Tecnologic/hardware_4850/jacobi.kicad_pcb

## KiCad design jacobi.kicad_pcb (2026-11-06)

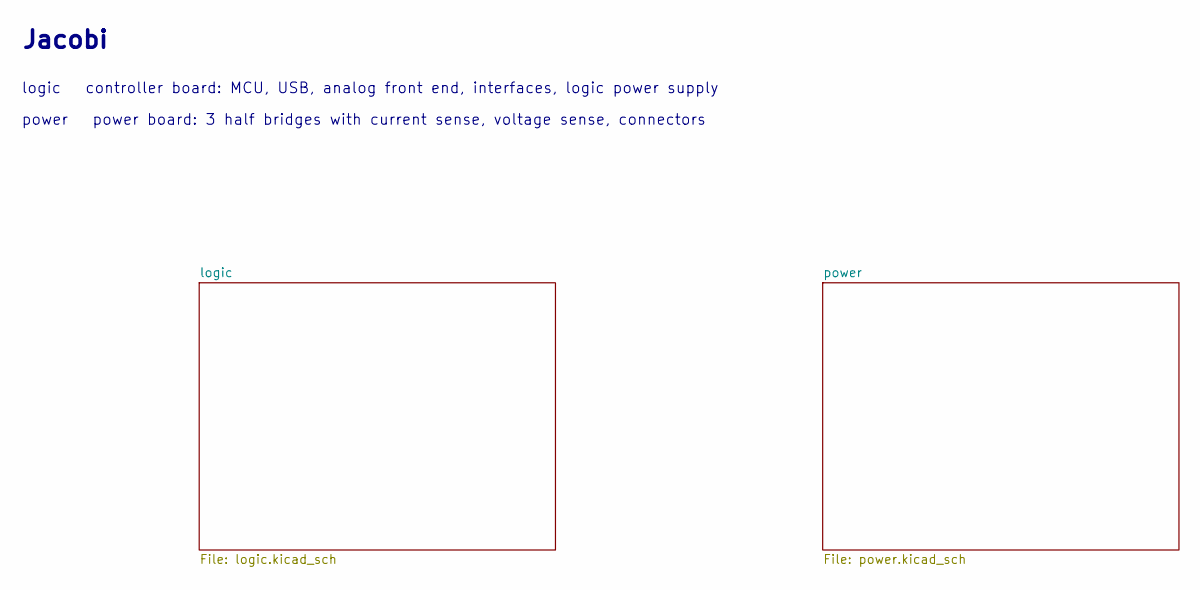
[picture p1: schematic jacobi.kicad_sch]

Notes on the sheet:
Jacobi
logic controller board: MCU, USB, analog front end, interfaces, logic power supply
power power board: 3 half bridges with current sense, voltage sense, connectors

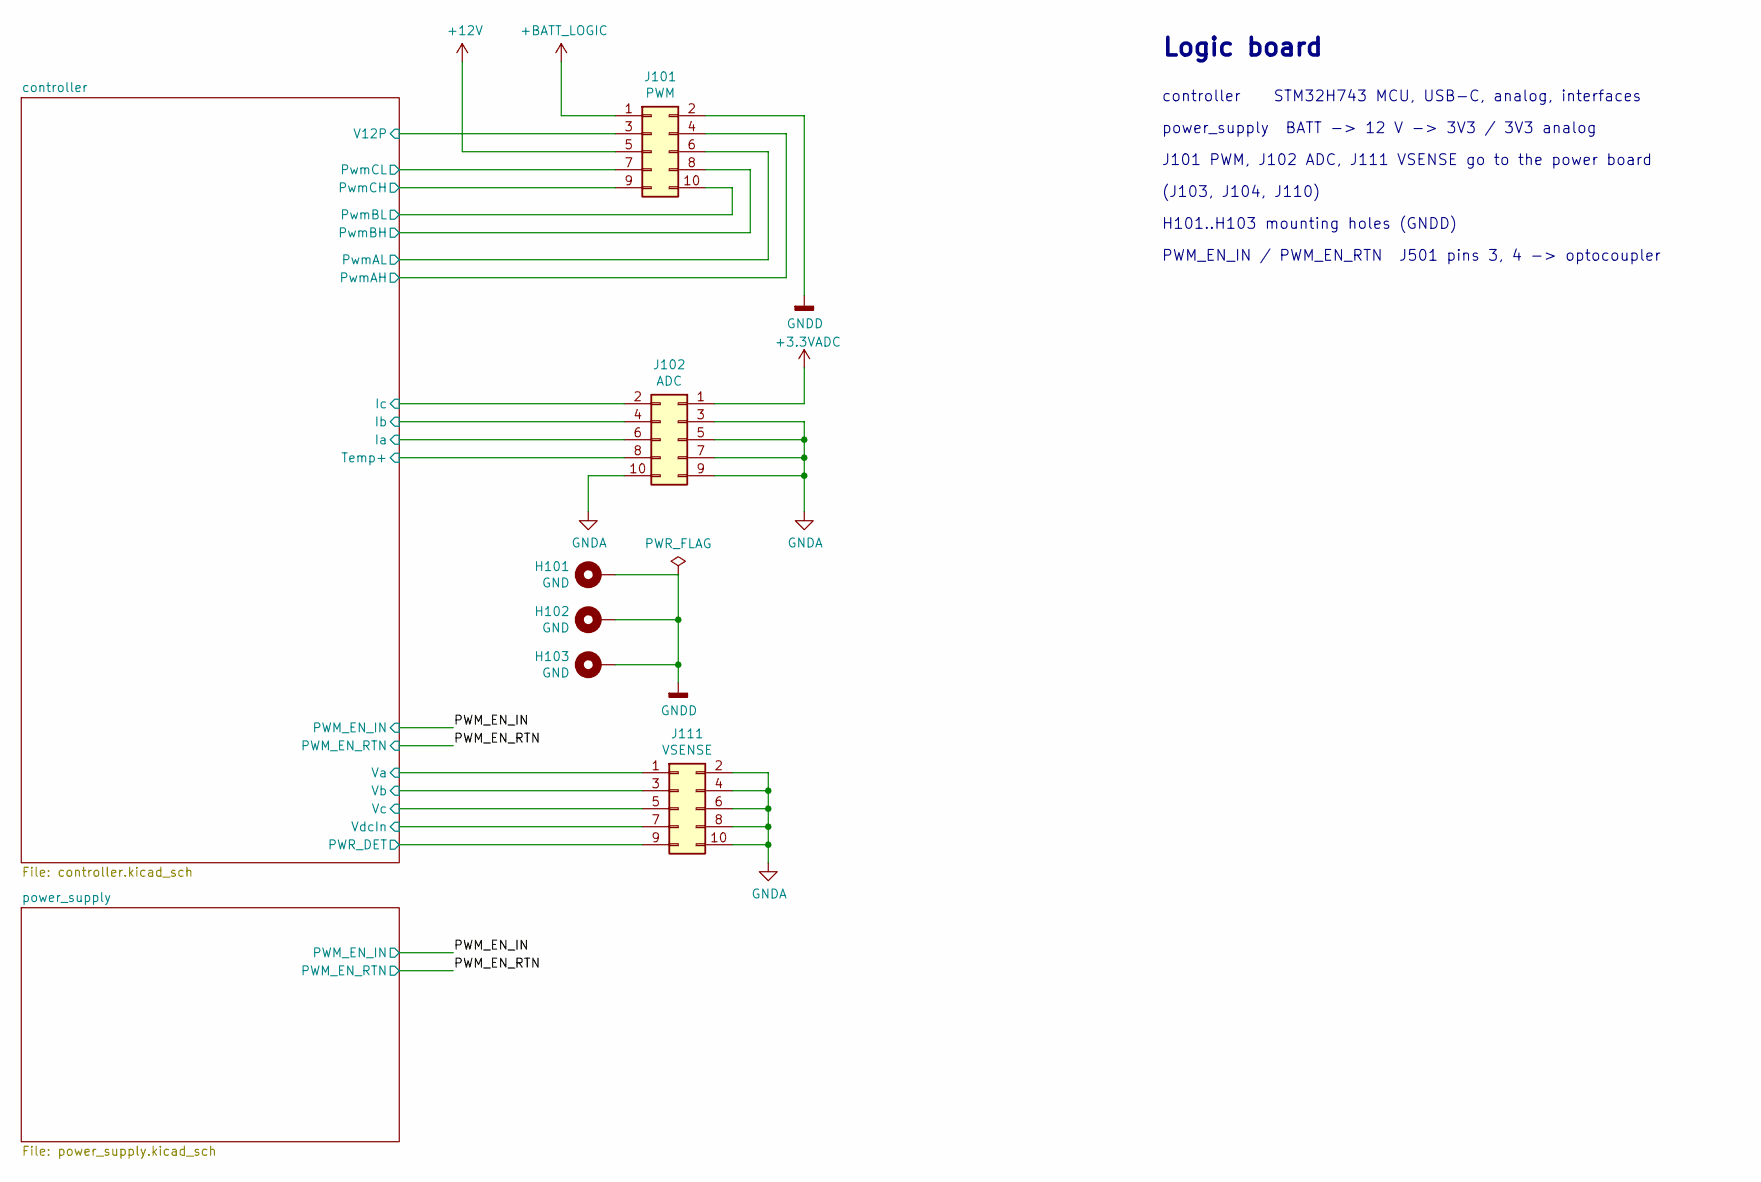
[picture p2: schematic logic.kicad_sch, Logic board]

Parts:
H101: GND; MountingHole_3.2mm_M3_Pad_Via
H102, H103: GND; MountingHole_3.2mm_M3_ISO14580_Pad
J101: PWM; PinHeader_2x05_P2.54mm_Vertical_SMD; Part# C124391
J102: ADC; PinHeader_2x05_P2.54mm_Vertical_SMD; Part# C124391
J111: VSENSE; PinHeader_2x05_P2.54mm_Vertical_SMD; Part# C124391

Connections:
+3.3VADC: J102.1; also elsewhere on the board
+12V: J101.5; also elsewhere on the board
+BATT_LOGIC: J101.1; also elsewhere on the board
/logic/controller/Ia: J102.6; also elsewhere on the board
/logic/controller/Ib: J102.4; also elsewhere on the board
/logic/controller/Ic: J102.2; also elsewhere on the board
/logic/controller/PWR_DET: J111.9; also elsewhere on the board
/logic/controller/PwmAH: J101.4; also elsewhere on the board
/logic/controller/PwmAL: J101.6; also elsewhere on the board
/logic/controller/PwmBH: J101.8; also elsewhere on the board
/logic/controller/PwmBL: J101.10; also elsewhere on the board
/logic/controller/PwmCH: J101.9; also elsewhere on the board
/logic/controller/PwmCL: J101.7; also elsewhere on the board
/logic/controller/Temp+: J102.8; also elsewhere on the board
/logic/controller/V12P: J101.3; also elsewhere on the board
/logic/controller/Va: J111.1; also elsewhere on the board
/logic/controller/Vb: J111.3; also elsewhere on the board
/logic/controller/Vc: J111.5; also elsewhere on the board
/logic/controller/VdcIn: J111.7; also elsewhere on the board
GNDA: J102.3, J102.5, J102.7, J102.9, J102.10, J111.2, J111.4, J111.6, J111.8, J111.10; also elsewhere on the board
GNDD: H101.1 (1_1), H102.1 (1_1), H103.1 (1_1), J101.2; also elsewhere on the board

Notes on the sheet:
power_supply BATT -> 12 V -> 3V3 / 3V3 analog
PWM_EN_IN / PWM_EN_RTN J501 pins 3, 4 -> optocoupler
(J103, J104, J110)
Logic board
J101 PWM, J102 ADC, J111 VSENSE go to the power board
controller STM32H743 MCU, USB-C, analog, interfaces
H101..H103 mounting holes (GNDD)

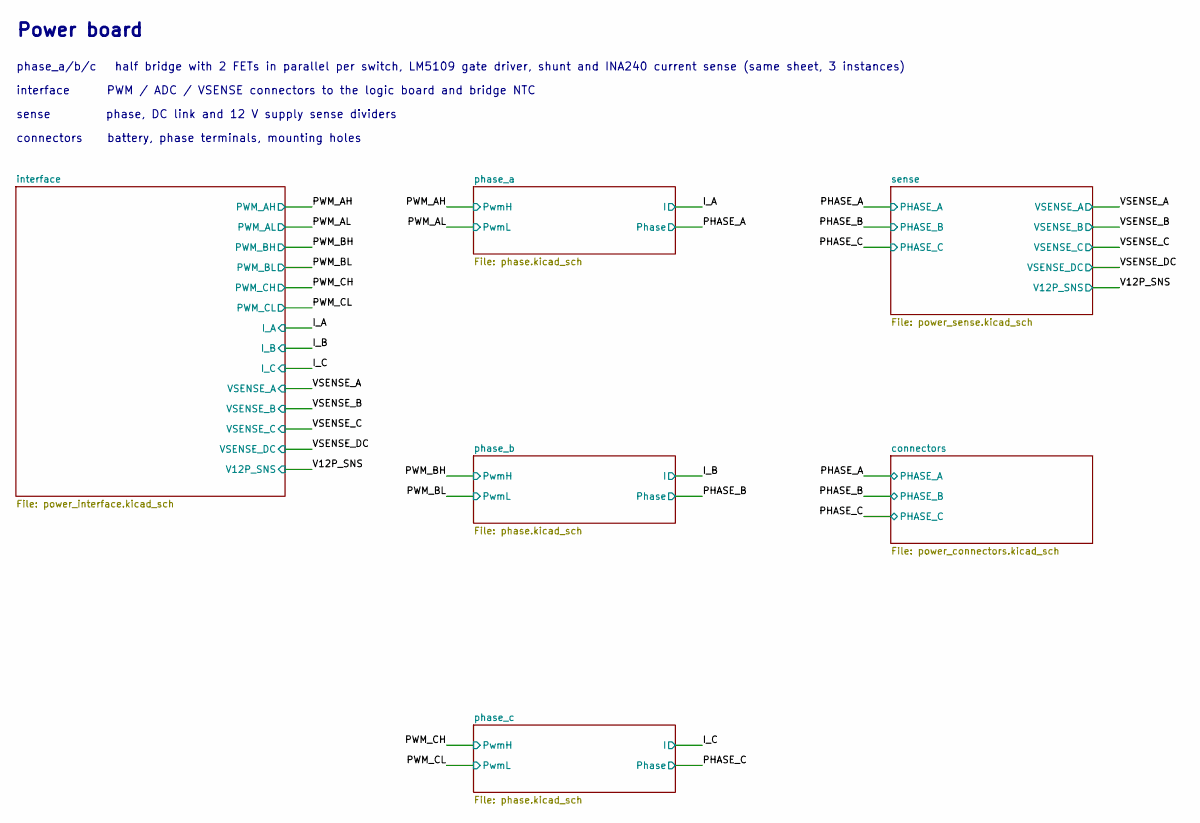
[picture p3: schematic power.kicad_sch, Power board]

Notes on the sheet:
phase_a/b/c half bridge with 2 FETs in parallel per switch, LM5109 gate driver, shunt and INA240 current sense (same sheet, 3 instances)
Power board
interface PWM / ADC / VSENSE connectors to the logic board and bridge NTC
sense phase, DC link and 12 V supply sense dividers
connectors battery, phase terminals, mounting holes

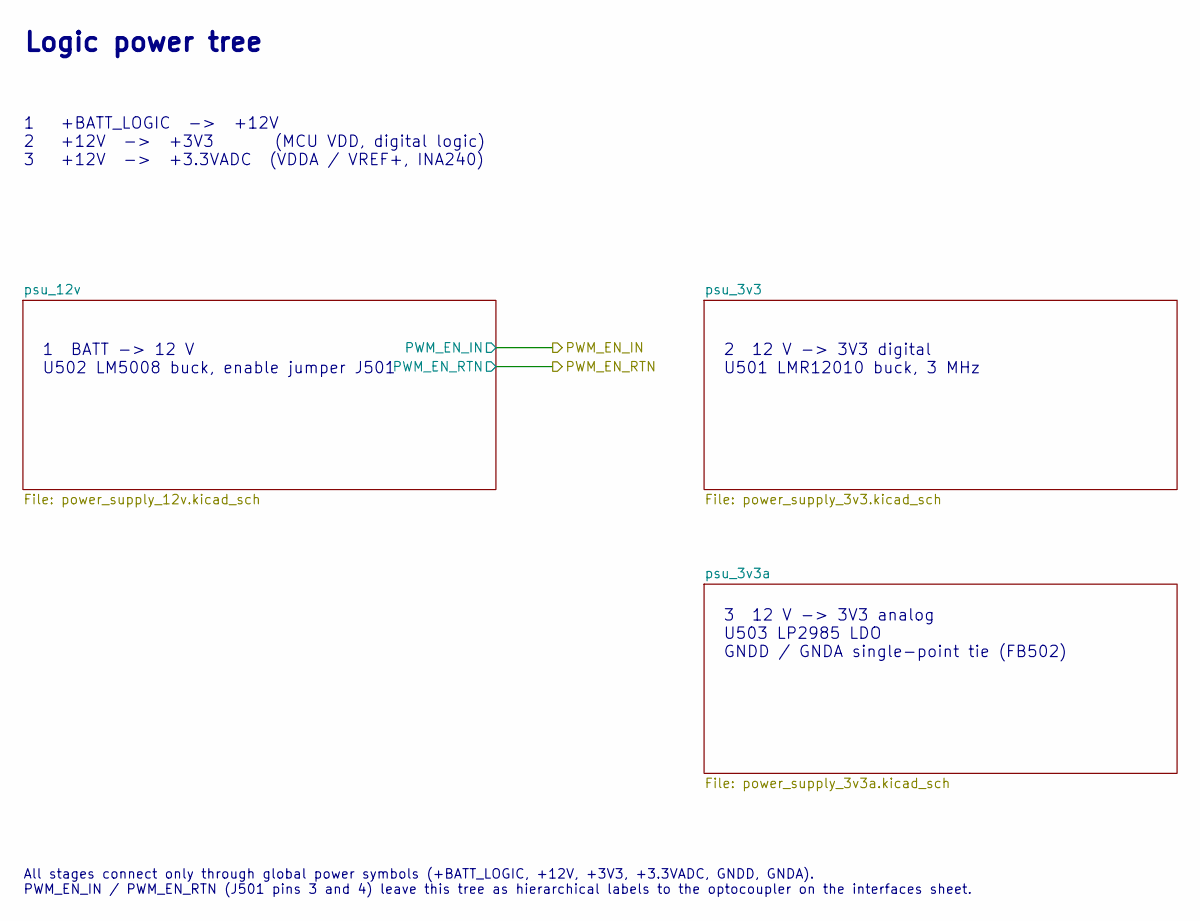
[picture p4: schematic power_supply.kicad_sch, Power supply overview: BATT -> 12V -> 3V3 / 3V3 analog]

Notes on the sheet:
All stages connect only through global power symbols (+BATT_LOGIC, +12V, +3V3, +3.3VADC, GNDD, GNDA). PWM_EN_IN / PWM_EN_RTN (J501 pins 3 and 4) leave this tree as hierarchical labels to the optocoupler on the interfaces sheet.
2 12 V -> 3V3 digital U501 LMR12010 buck, 3 MHz
3 12 V -> 3V3 analog U503 LP2985 LDO GNDD / GNDA single-point tie (FB502)
1 +BATT_LOGIC -> +12V 2 +12V -> +3V3 (MCU VDD, digital logic) 3 +12V -> +3.3VADC (VDDA / VREF+, INA240)
1 BATT -> 12 V U502 LM5008 buck, enable jumper J501
Logic power tree

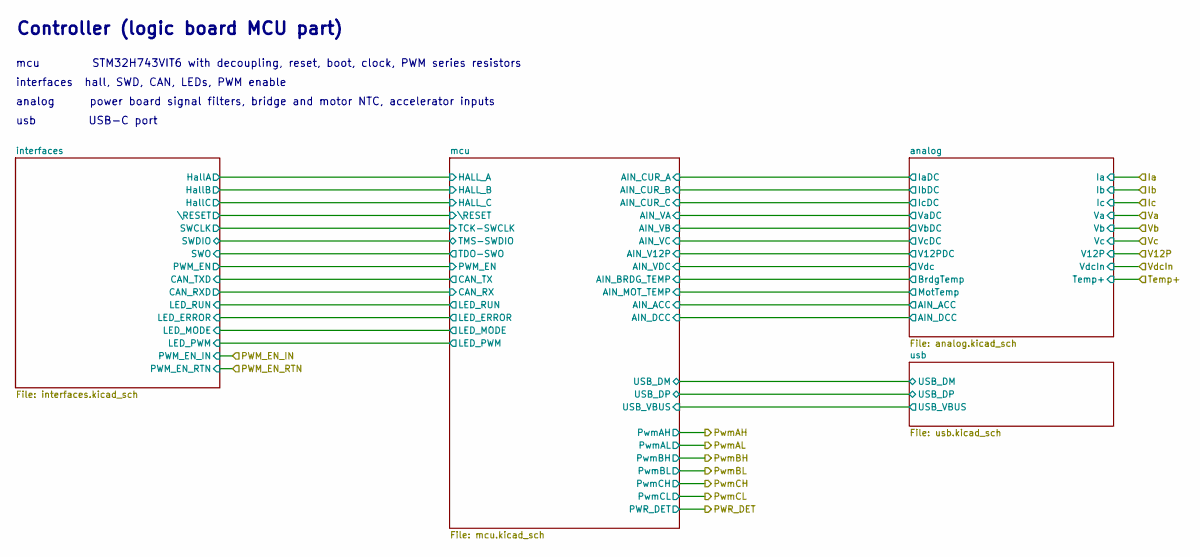
[picture p5: schematic controller.kicad_sch]

Notes on the sheet:
usb USB-C port
Controller (logic board MCU part)
mcu STM32H743VIT6 with decoupling, reset, boot, clock, PWM series resistors
interfaces hall, SWD, CAN, LEDs, PWM enable
analog power board signal filters, bridge and motor NTC, accelerator inputs

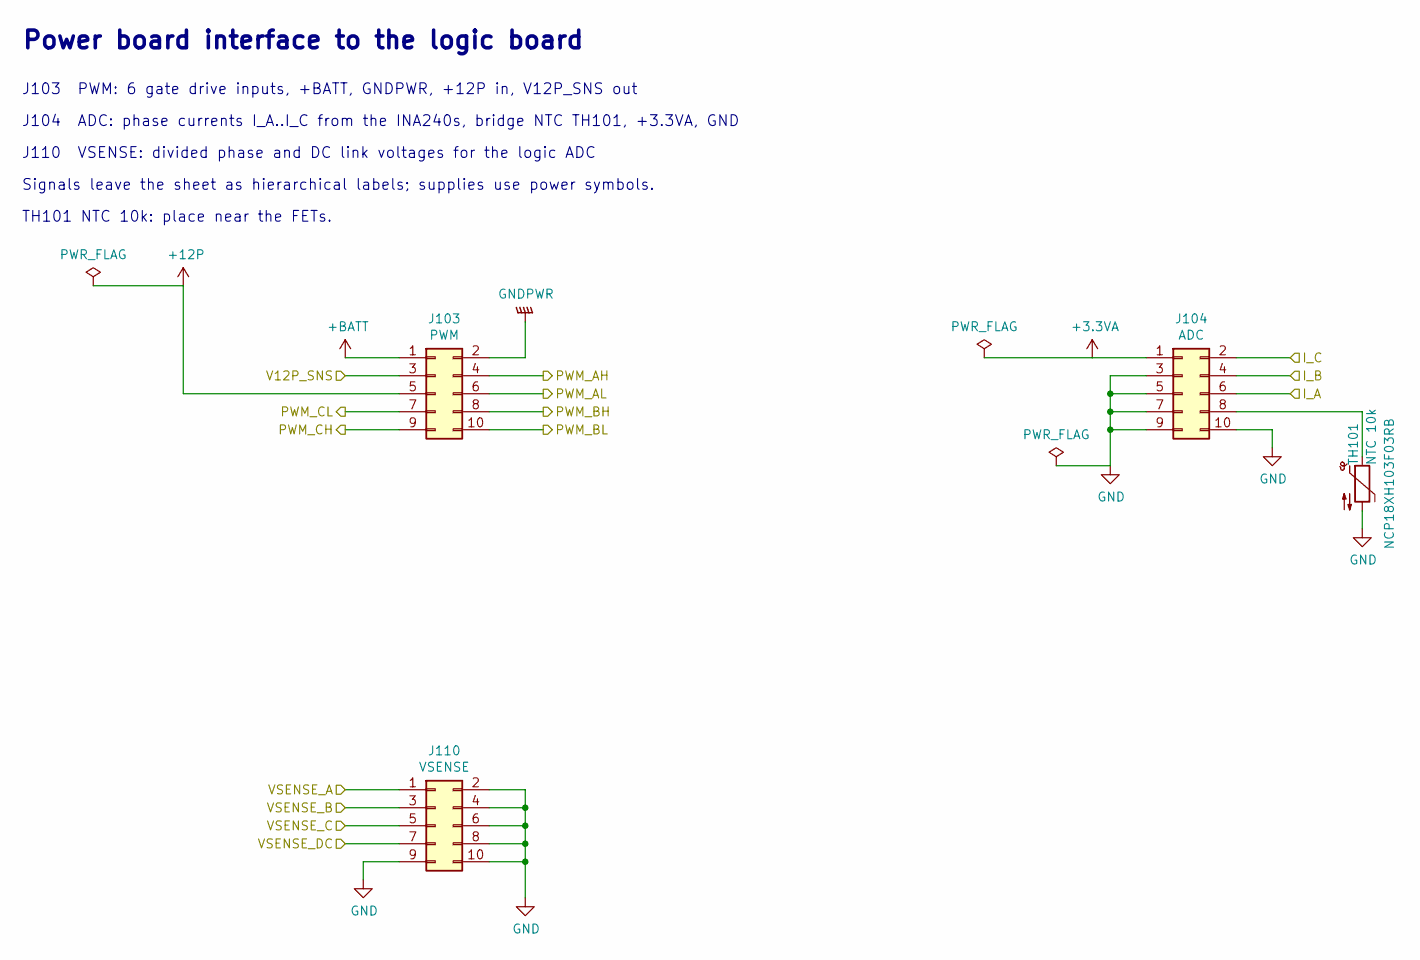
[picture p6: schematic power_interface.kicad_sch, Power board interface: PWM, ADC, VSENSE connectors]

Parts:
J103: PWM; PinSocket_2x05_P2.54mm_Vertical_SMD; Part# C261072
J104: ADC; PinSocket_2x05_P2.54mm_Vertical_SMD; Part# C261072
J110: VSENSE; PinSocket_2x05_P2.54mm_Vertical_SMD; Part# C261072
TH101: NTC 10k; R_0603_1608Metric; Part# NCP18XH103F03RB

Connections:
+3.3VA: J104.1; also elsewhere on the board
+12P: J103.5; also elsewhere on the board
+BATT: J103.1; also elsewhere on the board
/power/I_A: J104.6; also elsewhere on the board
/power/I_B: J104.4; also elsewhere on the board
/power/I_C: J104.2; also elsewhere on the board
/power/PWM_AH: J103.4; also elsewhere on the board
/power/PWM_AL: J103.6; also elsewhere on the board
/power/PWM_BH: J103.8; also elsewhere on the board
/power/PWM_BL: J103.10; also elsewhere on the board
/power/PWM_CH: J103.9; also elsewhere on the board
/power/PWM_CL: J103.7; also elsewhere on the board
/power/V12P_SNS: J103.3; also elsewhere on the board
/power/VSENSE_A: J110.1; also elsewhere on the board
/power/VSENSE_B: J110.3; also elsewhere on the board
/power/VSENSE_C: J110.5; also elsewhere on the board
/power/VSENSE_DC: J110.7; also elsewhere on the board
GND: J104.3, J104.5, J104.7, J104.9, J104.10, J110.2, J110.4, J110.6, J110.8, J110.9, J110.10, TH101.2; also elsewhere on the board
GNDPWR: J103.2; also elsewhere on the board
unnamed: J104.8, TH101.1

Notes on the sheet:
J110 VSENSE: divided phase and DC link voltages for the logic ADC
TH101 NTC 10k: place near the FETs.
J103 PWM: 6 gate drive inputs, +BATT, GNDPWR, +12P in, V12P_SNS out
Signals leave the sheet as hierarchical labels; supplies use power symbols.
Power board interface to the logic board
J104 ADC: phase currents I_A..I_C from the INA240s, bridge NTC TH101, +3.3VA, GND

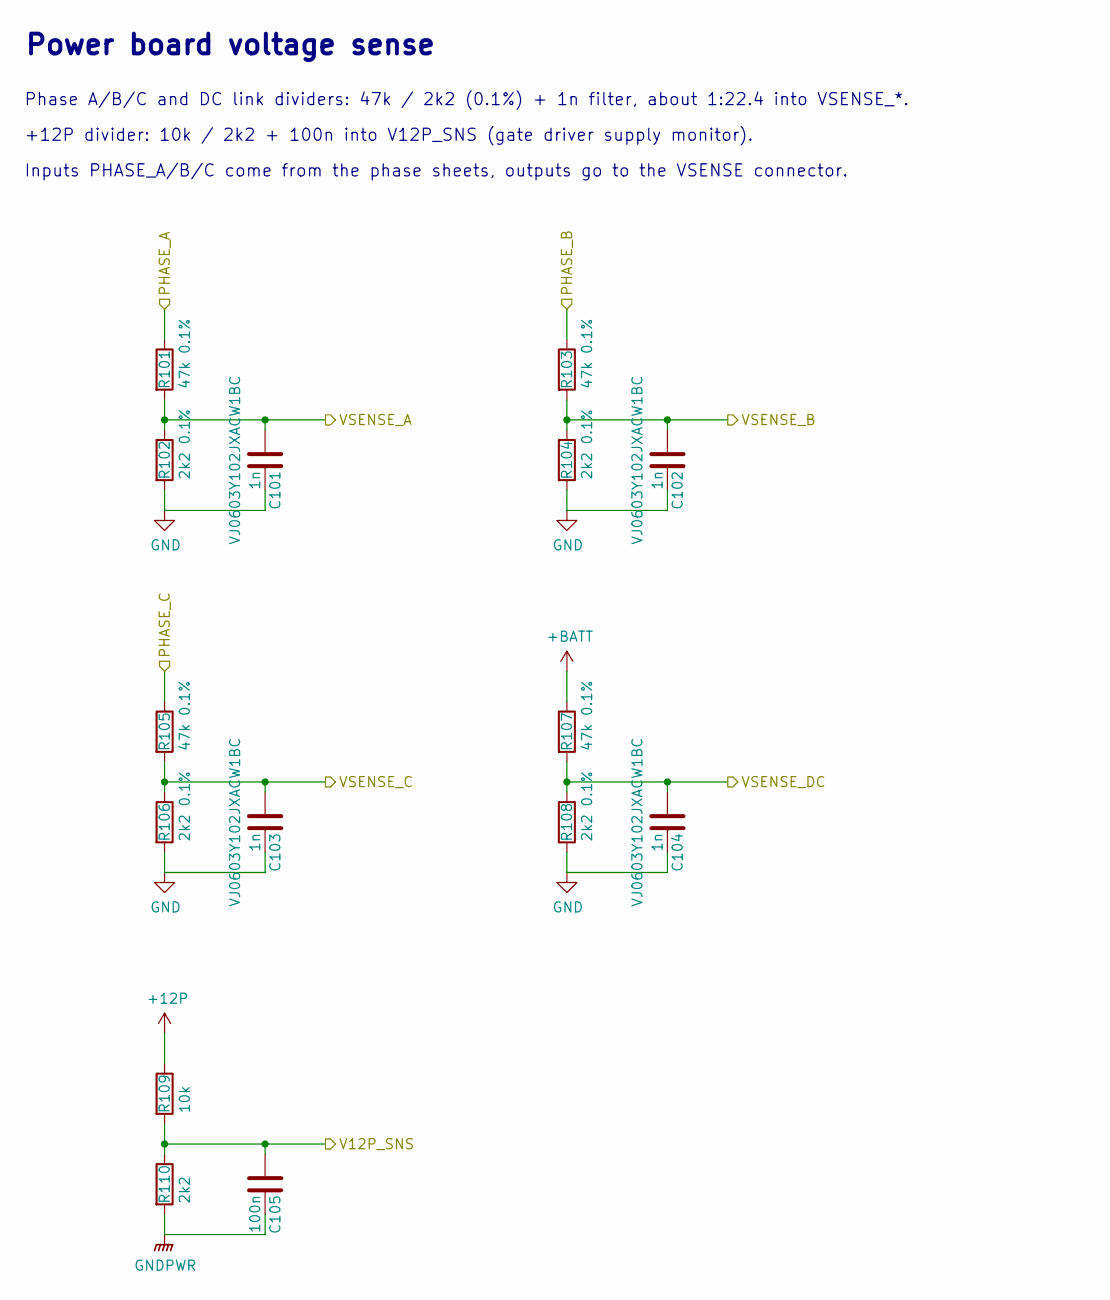
[picture p7: schematic power_sense.kicad_sch, Power board voltage sense dividers]

Parts:
C101, C102, C103, C104: 1n; C_0603_1608Metric; Part# VJ0603Y102JXACW1BC
C105: 100n; C_0603_1608Metric
R101, R103, R105, R107: 47k 0.1%; R_0805_2012Metric
R102, R104, R106, R108: 2k2 0.1%; R_0603_1608Metric
R109: 10k; R_0603_1608Metric
R110: 2k2; R_0603_1608Metric

Connections:
+12P: R109.1; also elsewhere on the board
+BATT: R107.1; also elsewhere on the board
/power/PHASE_A: R101.1; also elsewhere on the board
/power/PHASE_B: R103.1; also elsewhere on the board
/power/PHASE_C: R105.1; also elsewhere on the board
/power/V12P_SNS: C105.2, R109.2, R110.1; also elsewhere on the board
/power/VSENSE_A: C101.2, R101.2, R102.1; also elsewhere on the board
/power/VSENSE_B: C102.2, R103.2, R104.1; also elsewhere on the board
/power/VSENSE_C: C103.2, R105.2, R106.1; also elsewhere on the board
/power/VSENSE_DC: C104.2, R107.2, R108.1; also elsewhere on the board
GND: C101.1, C102.1, C103.1, C104.1, R102.2, R104.2, R106.2, R108.2; also elsewhere on the board
GNDPWR: C105.1, R110.2; also elsewhere on the board

Notes on the sheet:
Inputs PHASE_A/B/C come from the phase sheets, outputs go to the VSENSE connector.
+12P divider: 10k / 2k2 + 100n into V12P_SNS (gate driver supply monitor).
Power board voltage sense
Phase A/B/C and DC link dividers: 47k / 2k2 (0.1%) + 1n filter, about 1:22.4 into VSENSE_*.

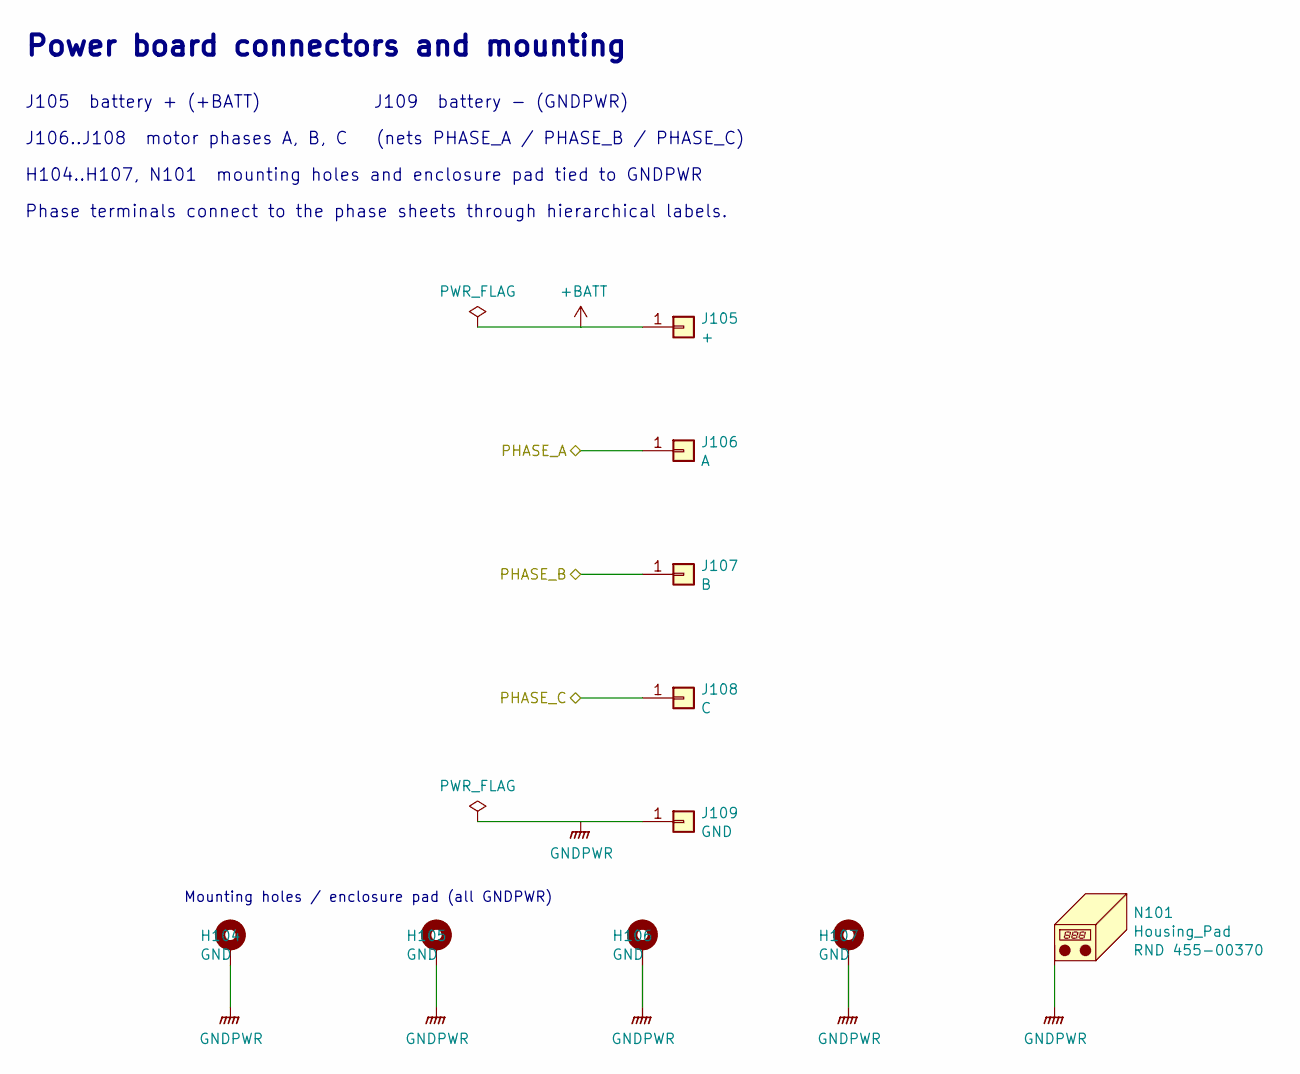
[picture p8: schematic power_connectors.kicad_sch, Power connectors: battery, phases, mounting]

Parts:
H104, H107: GND; MountingHole_3.2mm_M3_ISO14580_Pad
H105, H106: GND; MountingHole_3.2mm_M3_Pad_Via
J105: +; Terminal_M3_XFCN_TT34086077-0910; LCSC C19724597
J106: A; Terminal_M3_XFCN_TT34086077-0910; LCSC C19724597
J107: B; Terminal_M3_XFCN_TT34086077-0910; LCSC C19724597
J108: C; Terminal_M3_XFCN_TT34086077-0910; LCSC C19724597
J109: GND; Terminal_M3_XFCN_TT34086077-0910; LCSC C19724597
N101: Housing_Pad; RND-455-00370; Part# RND 455-00370

Connections:
+BATT: J105.1 (Pin_1_1); also elsewhere on the board
/power/PHASE_A: J106.1 (Pin_1_1); also elsewhere on the board
/power/PHASE_B: J107.1 (Pin_1_1); also elsewhere on the board
/power/PHASE_C: J108.1 (Pin_1_1); also elsewhere on the board
GNDPWR: H104.1 (1_1), H105.1 (1_1), H106.1 (1_1), H107.1 (1_1), J109.1 (Pin_1_1), N101.1 (PAD_1); also elsewhere on the board

Notes on the sheet:
J106..J108 motor phases A, B, C (nets PHASE_A / PHASE_B / PHASE_C)
Phase terminals connect to the phase sheets through hierarchical labels.
J105 battery + (+BATT) J109 battery - (GNDPWR)
Power board connectors and mounting
H104..H107, N101 mounting holes and enclosure pad tied to GNDPWR
Mounting holes / enclosure pad (all GNDPWR)

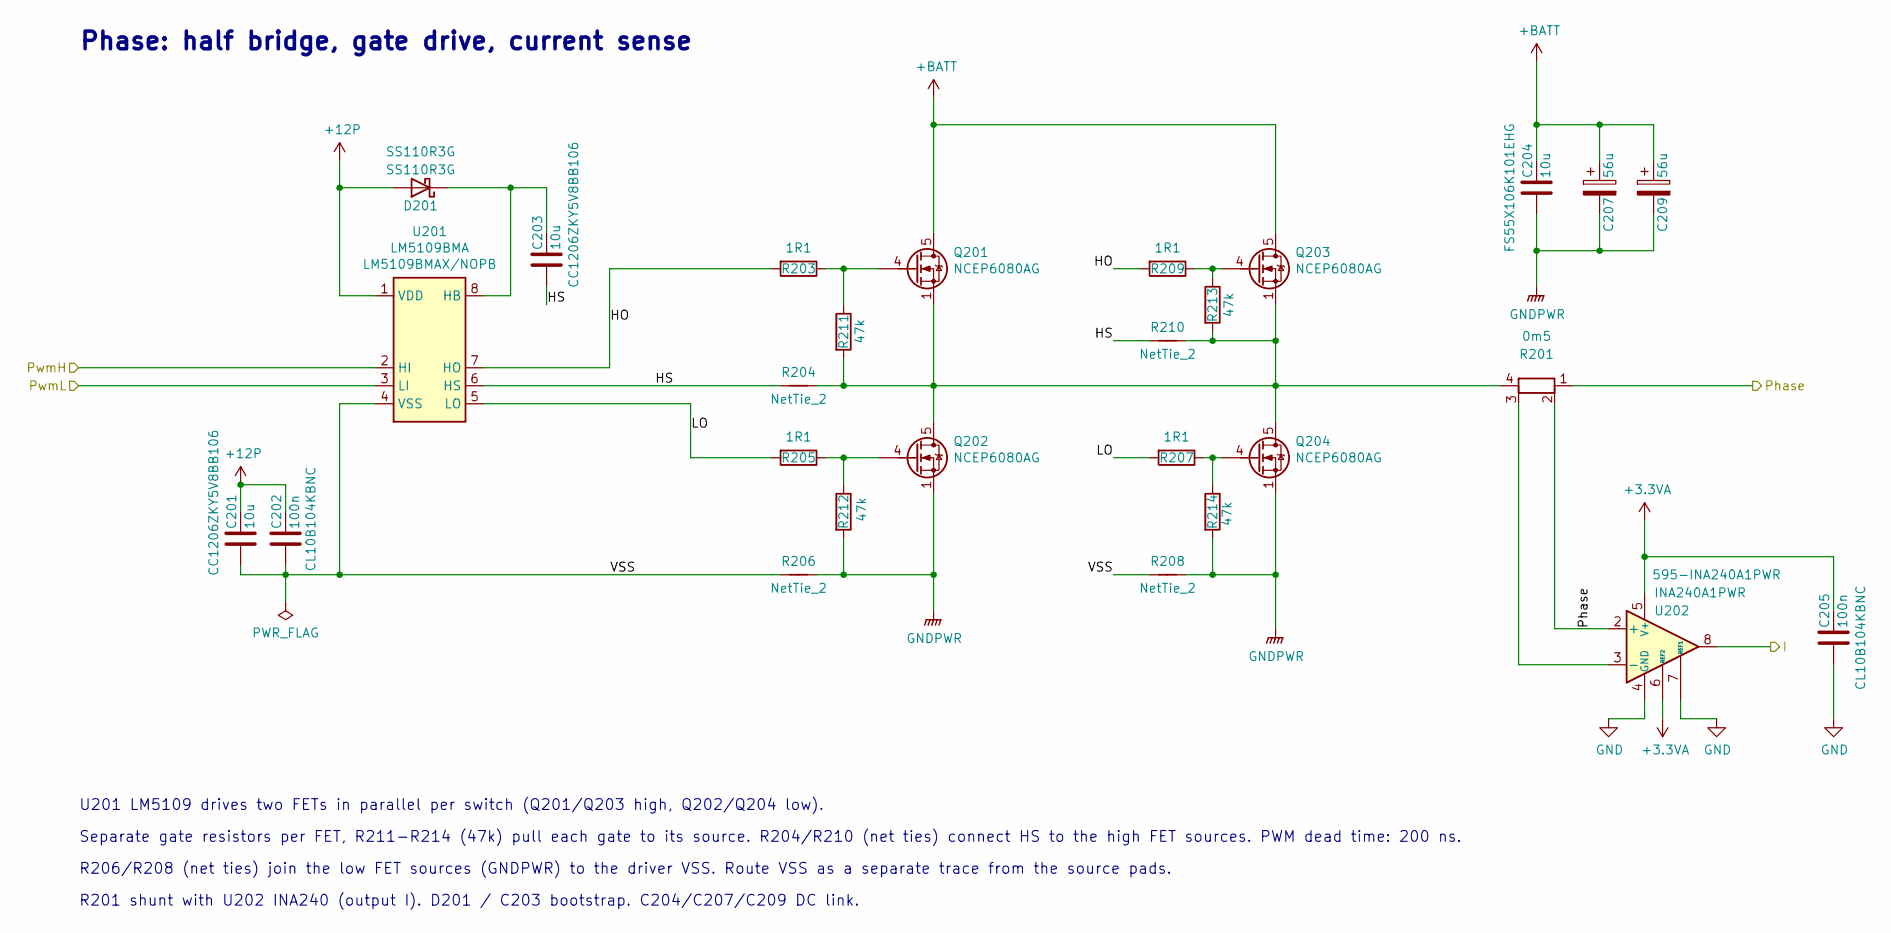
[picture p9: schematic phase.kicad_sch]

Parts:
C201, C203: 10u; C_1206_3216Metric; Part# CC1206ZKY5V8BB106
C202, C205: 100n; C_0603_1608Metric; Part# CL10B104KBNC
C204: 10u; C_2220_5650Metric; Part# FS55X106K101EHG
C207, C209: 56u; CP_Elec_10x10
D201: SS110R3G; D_SMA; Part# SS110R3G
Q201, Q202, Q203, Q204: NCEP6080AG; LFPAK56_ThermalVias-1
R201: 0m5; R_Shunt_Yezhan_DSLR-5_3920_Kelvin; Part# DSLR-M-5-0.5F; LCSC C41382689
R203, R205, R207, R209: 1R1; R_0603_1608Metric
R204, R206, R208, R210: NetTie_2; NetTie-2_SMD_Pad0.5mm
R211, R212, R213, R214: 47k; R_0603_1608Metric
U201: LM5109BMA; SOIC-8_3.9x4.9mm_P1.27mm; Part# LM5109BMAX/NOPB
U202: INA240A1PWR; TSSOP-8_4.4x3mm_P0.65mm; Part# 595-INA240A1PWR

Connections:
+3.3VA: C205.1, U202.5 (V+), U202.6 (REF2); also elsewhere on the board
+12P: C201.1, C202.1, D201.2 (A), U201.1 (VDD); also elsewhere on the board
+BATT: C204.1, C207.1, C209.1, Q201.5 (D), Q203.5 (D); also elsewhere on the board
/power/I_A: U202.8; also elsewhere on the board
/power/PHASE_A: R201.1, R201.2, U202.2 (+); also elsewhere on the board
/power/PWM_AH: U201.2 (HI); also elsewhere on the board
/power/PWM_AL: U201.3 (LI); also elsewhere on the board
/power/phase_a/HO: R203.2, R209.2, U201.7 (HO)
/power/phase_a/HS: C203.2, R204.1, R210.1, U201.6 (HS)
/power/phase_a/LO: R205.2, R207.2, U201.5 (LO)
/power/phase_a/VSS: C201.2, C202.2, R206.1, R208.1, U201.4 (VSS)
GND: C205.2, U202.1 (GND), U202.4 (GND), U202.7 (REF1); also elsewhere on the board
GNDPWR: C204.2, C207.2, C209.2, Q202.1 (S), Q202.2 (S), Q202.3 (S), Q204.1 (S), Q204.2 (S), Q204.3 (S), R206.2, R208.2, R212.2, R214.2; also elsewhere on the board
unnamed: C203.1, D201.1 (K), U201.8 (HB)
unnamed: Q201.4 (G), R203.1, R211.1
unnamed: Q201.1 (S), Q201.2 (S), Q201.3 (S), Q202.5 (D), Q203.1 (S), Q203.2 (S), Q203.3 (S), Q204.5 (D), R201.4, R204.2, R210.2, R211.2, R213.2
unnamed: Q202.4 (G), R205.1, R212.1
unnamed: Q203.4 (G), R209.1, R213.1
unnamed: Q204.4 (G), R207.1, R214.1
unnamed: R201.3, U202.3 (-)

Parts of its further copies:
C301, C303, C401, C403: 10u; C_1206_3216Metric; Part# CC1206ZKY5V8BB106
C302, C305, C402, C405: 100n; C_0603_1608Metric; Part# CL10B104KBNC
C304, C404: 10u; C_2220_5650Metric; Part# FS55X106K101EHG
C307, C309, C407, C409: 56u; CP_Elec_10x10
D301, D401: SS110R3G; D_SMA; Part# SS110R3G
Q301, Q302, Q303, Q304, Q401, Q402, Q403, Q404: NCEP6080AG; LFPAK56_ThermalVias-1
R301, R401: 0m5; R_Shunt_Yezhan_DSLR-5_3920_Kelvin; Part# DSLR-M-5-0.5F; LCSC C41382689
R303, R305, R307, R309, R403, R405, R407, R409: 1R1; R_0603_1608Metric
R304, R306, R308, R310, R404, R406, R408, R410: NetTie_2; NetTie-2_SMD_Pad0.5mm
R311, R312, R313, R314, R411, R412, R413, R414: 47k; R_0603_1608Metric
U301, U401: LM5109BMA; SOIC-8_3.9x4.9mm_P1.27mm; Part# LM5109BMAX/NOPB
U302, U402: INA240A1PWR; TSSOP-8_4.4x3mm_P0.65mm; Part# 595-INA240A1PWR

Connections of its further copies:
+3.3VA: C305.1, C405.1, U302.5 (V+), U302.6 (REF2), U402.5 (V+), U402.6 (REF2); also elsewhere on the board
+12P: C301.1, C302.1, C401.1, C402.1, D301.2 (A), D401.2 (A), U301.1 (VDD), U401.1 (VDD); also elsewhere on the board
+BATT: C304.1, C307.1, C309.1, C404.1, C407.1, C409.1, Q301.5 (D), Q303.5 (D), Q401.5 (D), Q403.5 (D); also elsewhere on the board
/power/I_B: U302.8; also elsewhere on the board
/power/I_C: U402.8; also elsewhere on the board
/power/PHASE_B: R301.1, R301.2, U302.2 (+); also elsewhere on the board
/power/PHASE_C: R401.1, R401.2, U402.2 (+); also elsewhere on the board
/power/PWM_BH: U301.2 (HI); also elsewhere on the board
/power/PWM_BL: U301.3 (LI); also elsewhere on the board
/power/PWM_CH: U401.2 (HI); also elsewhere on the board
/power/PWM_CL: U401.3 (LI); also elsewhere on the board
/power/phase_b/HO: R303.2, R309.2, U301.7 (HO)
/power/phase_b/HS: C303.2, R304.1, R310.1, U301.6 (HS)
/power/phase_b/LO: R305.2, R307.2, U301.5 (LO)
/power/phase_b/VSS: C301.2, C302.2, R306.1, R308.1, U301.4 (VSS)
/power/phase_c/HO: R403.2, R409.2, U401.7 (HO)
/power/phase_c/HS: C403.2, R404.1, R410.1, U401.6 (HS)
/power/phase_c/LO: R405.2, R407.2, U401.5 (LO)
/power/phase_c/VSS: C401.2, C402.2, R406.1, R408.1, U401.4 (VSS)
GND: C305.2, C405.2, U302.1 (GND), U302.4 (GND), U302.7 (REF1), U402.1 (GND), U402.4 (GND), U402.7 (REF1); also elsewhere on the board
GNDPWR: C304.2, C307.2, C309.2, C404.2, C407.2, C409.2, Q302.1 (S), Q302.2 (S), Q302.3 (S), Q304.1 (S), Q304.2 (S), Q304.3 (S), Q402.1 (S), Q402.2 (S), Q402.3 (S), Q404.1 (S), Q404.2 (S), Q404.3 (S), R306.2, R308.2, R312.2, R314.2, R406.2, R408.2, R412.2, R414.2; also elsewhere on the board
unnamed: C303.1, D301.1 (K), U301.8 (HB)
unnamed: C403.1, D401.1 (K), U401.8 (HB)
unnamed: Q301.4 (G), R303.1, R311.1
unnamed: Q301.1 (S), Q301.2 (S), Q301.3 (S), Q302.5 (D), Q303.1 (S), Q303.2 (S), Q303.3 (S), Q304.5 (D), R301.4, R304.2, R310.2, R311.2, R313.2
unnamed: Q302.4 (G), R305.1, R312.1
unnamed: Q303.4 (G), R309.1, R313.1
unnamed: Q304.4 (G), R307.1, R314.1
unnamed: Q401.4 (G), R403.1, R411.1
unnamed: Q401.1 (S), Q401.2 (S), Q401.3 (S), Q402.5 (D), Q403.1 (S), Q403.2 (S), Q403.3 (S), Q404.5 (D), R401.4, R404.2, R410.2, R411.2, R413.2
unnamed: Q402.4 (G), R405.1, R412.1
unnamed: Q403.4 (G), R409.1, R413.1
unnamed: Q404.4 (G), R407.1, R414.1
unnamed: R301.3, U302.3 (-)
unnamed: R401.3, U402.3 (-)

Notes on the sheet:
Phase: half bridge, gate drive, current sense
R201 shunt with U202 INA240 (output I). D201 / C203 bootstrap. C204/C207/C209 DC link.
U201 LM5109 drives two FETs in parallel per switch (Q201/Q203 high, Q202/Q204 low).
Separate gate resistors per FET, R211-R214 (47k) pull each gate to its source. R204/R210 (net ties) connect HS to the high FET sources. PWM dead time: 200 ns.
R206/R208 (net ties) join the low FET sources (GNDPWR) to the driver VSS. Route VSS as a separate trace from the source pads.

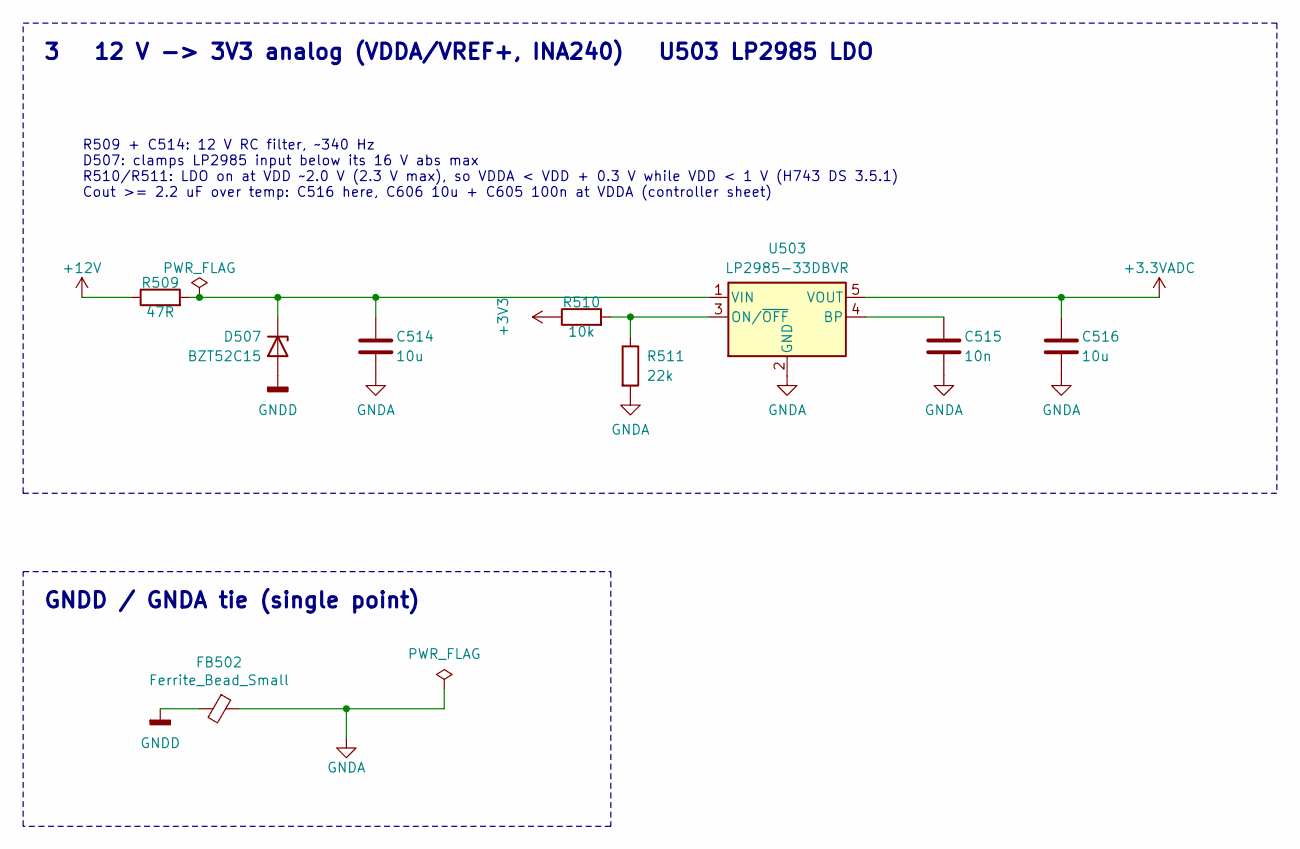
[picture p10: schematic power_supply_3v3a.kicad_sch, Power supply 3: 12 V -> 3V3 analog (LP2985)]

Parts:
C514, C516: 10u; C_0805_2012Metric; Part# CL21A106KAYNNNE
C515: 10n; C_0603_1608Metric; Part# CL10B103KB8NNNC
D507: BZT52C15; D_SOD-123; Part# BZT52C15
FB502: Ferrite_Bead_Small; R_0603_1608Metric; Part# ACML-0603-2000
R509: 47R; R_0805_2012Metric; Part# RC0805FR-0747RL
R510: 10k; R_0603_1608Metric; Part# MCR03ERTJ103
R511: 22k; R_0603_1608Metric; Part# MCR03ERTJ223
U503: LP2985-33DBVR; SOT-23-5; Part# LP2985-33DBVR

Connections:
+3.3VADC: C516.1, U503.5 (VOUT); also elsewhere on the board
+3V3: R510.1; also elsewhere on the board
+12V: R509.1; also elsewhere on the board
GNDA: C514.2, C515.2, C516.2, FB502.1, R511.2, U503.2 (GND); also elsewhere on the board
GNDD: D507.2 (A), FB502.2; also elsewhere on the board
unnamed: C514.1, D507.1 (K), R509.2, U503.1 (VIN)
unnamed: C515.1, U503.4 (BP)
unnamed: R510.2, R511.1, U503.3 (ON/~OFF)

Notes on the sheet:
R509 + C514: 12 V RC filter, ~340 Hz D507: clamps LP2985 input below its 16 V abs max R510/R511: LDO on at VDD ~2.0 V (2.3 V max), so VDDA < VDD + 0.3 V while VDD < 1 V (H743 DS 3.5.1) Cout >= 2.2 uF over temp: C516 here, C606 10u + C605 100n at VDDA (controller sheet)
GNDD / GNDA tie (single point)
3 12 V -> 3V3 analog (VDDA/VREF+, INA240) U503 LP2985 LDO

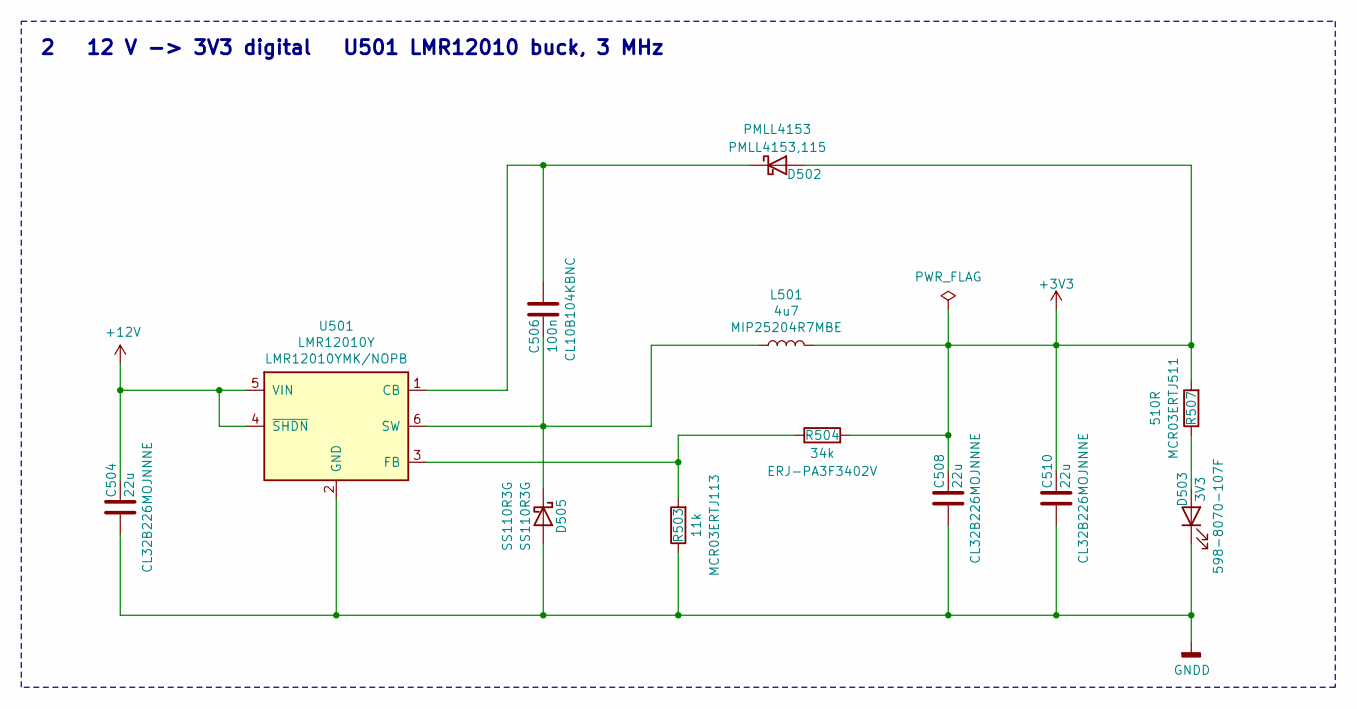
[picture p11: schematic power_supply_3v3.kicad_sch, Power supply 2: 12 V -> 3V3 digital (LMR12010 buck)]

Parts:
C504, C508, C510: 22u; C_1210_3225Metric; Part# CL32B226MOJNNNE
C506: 100n; C_0603_1608Metric; Part# CL10B104KBNC
D502: PMLL4153; D_MiniMELF; Part# PMLL4153,115
D503: 3V3; LED_0603_1608Metric; Part# 598-8070-107F
D505: SS110R3G; D_SMA; Part# SS110R3G
L501: 4u7; L_1206_3216Metric; Part# MIP25204R7MBE
R503: 11k; R_0603_1608Metric; Part# MCR03ERTJ113
R504: 34k; R_0603_1608Metric; Part# ERJ-PA3F3402V
R507: 510R; R_0603_1608Metric; Part# MCR03ERTJ511
U501: LMR12010Y; SOT-23-6; Part# LMR12010YMK/NOPB

Connections:
+3V3: C508.1, C510.1, D502.2 (A), L501.2, R504.2, R507.2; also elsewhere on the board
+12V: C504.1, U501.4 (~SHDN), U501.5 (VIN); also elsewhere on the board
GNDD: C504.2, C508.2, C510.2, D503.1 (K), D505.2 (A), R503.1, U501.2 (GND); also elsewhere on the board
unnamed: C506.2, D502.1 (K), U501.1 (CB)
unnamed: D503.2 (A), R507.1
unnamed: C506.1, D505.1 (K), L501.1, U501.6 (SW)
unnamed: R503.2, R504.1, U501.3 (FB)

Notes on the sheet:
2 12 V -> 3V3 digital U501 LMR12010 buck, 3 MHz
