Tecnologic/hardware_4850/jacobi.kicad_pcb

## KiCad design jacobi.kicad_pcb (continued)

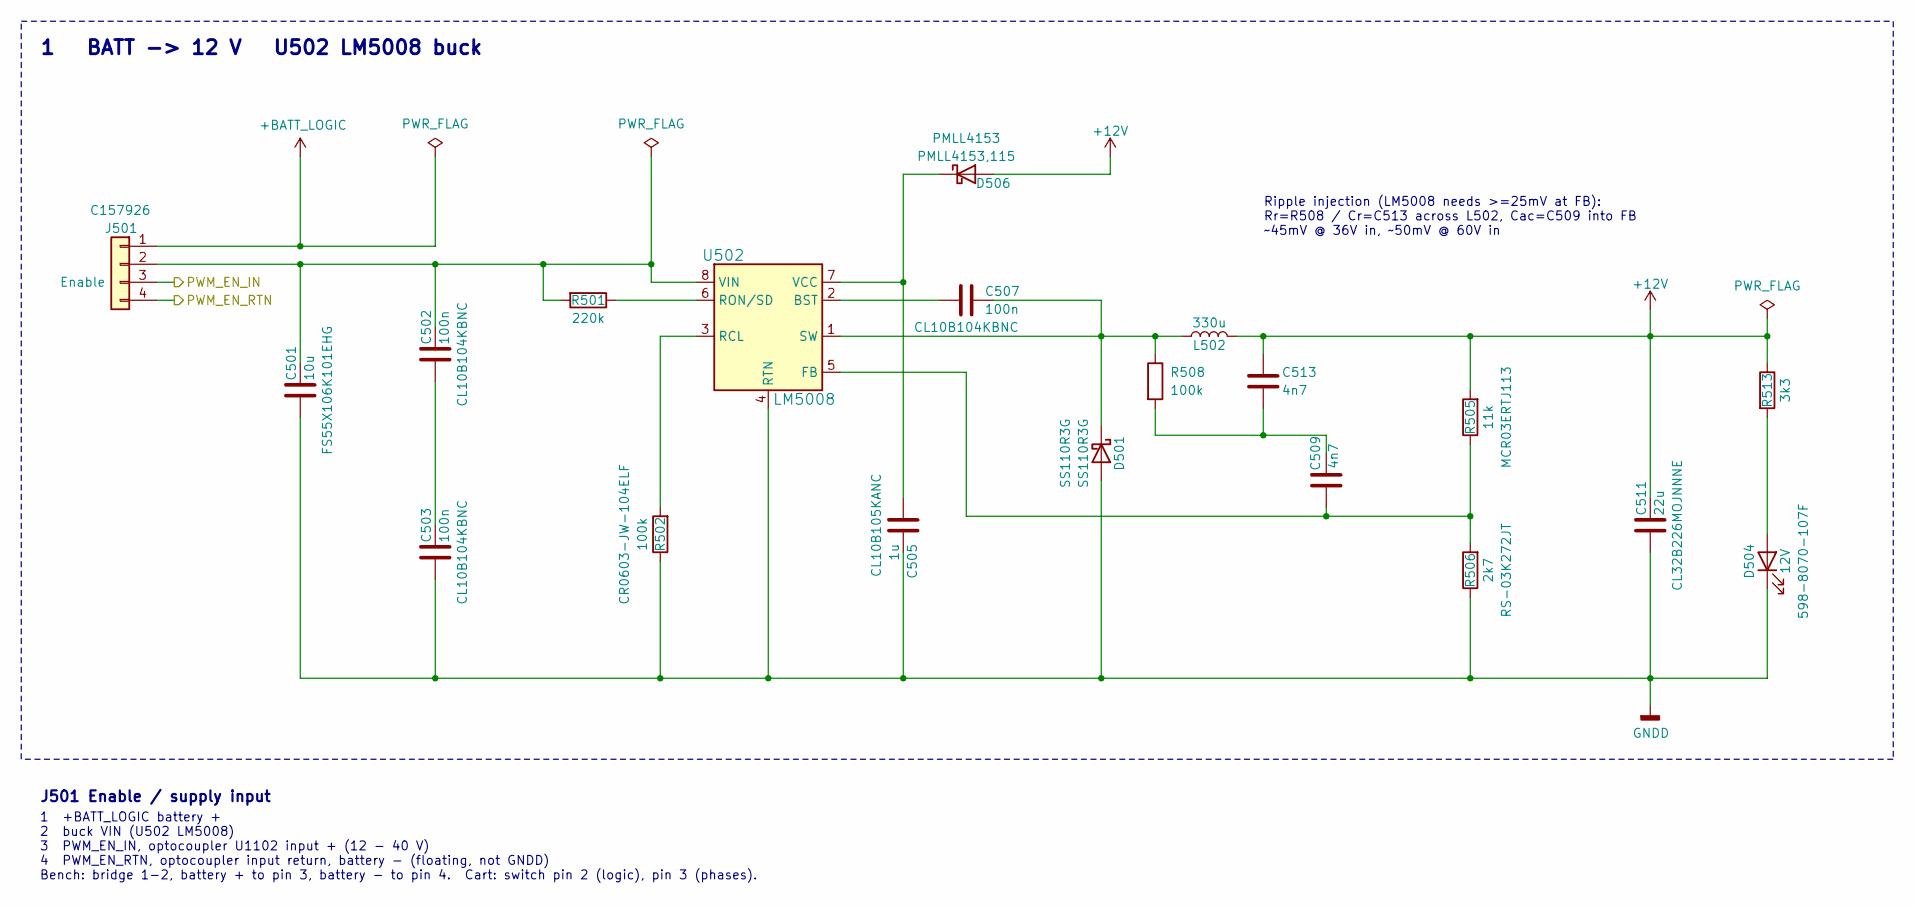
[picture p12: schematic power_supply_12v.kicad_sch, Power supply 1: BATT -> 12 V (LM5008 buck)]

Parts:
C501: 10u; C_2220_5650Metric; Part# FS55X106K101EHG
C502, C503, C507: 100n; C_0603_1608Metric; Part# CL10B104KBNC
C505: 1u; C_0603_1608Metric; Part# CL10B105KANC
C509, C513: 4n7; C_0603_1608Metric; Part# GRM1885C1H472JA01D
C511: 22u; C_1210_3225Metric; Part# CL32B226MOJNNNE
D501: SS110R3G; D_SMA; Part# SS110R3G
D504: 12V; LED_0603_1608Metric; Part# 598-8070-107F
D506: PMLL4153; D_MiniMELF; Part# PMLL4153,115
J501: Enable; JST_PH_S4B-PH-K_1x04_P2.00mm_Horizontal; Part# C157926
L502: 330u; L_Taiyo-Yuden_NR-80xx_HandSoldering; Part# SMNR8040-331MT
R501: 220k; R_0603_1608Metric; Part# CR0603JA0224G
R502: 100k; R_0603_1608Metric; Part# CR0603-JW-104ELF
R505: 11k; R_0603_1608Metric; Part# MCR03ERTJ113
R506: 2k7; R_0603_1608Metric; Part# RS-03K272JT
R508: 100k; R_0603_1608Metric; Part# MCR03ERTJ104
R513: 3k3; R_0603_1608Metric
U502: LM5008; MSOP-8_3x3mm_P0.65mm; Part# LM5008MMX/NOPB

Connections:
+12V: C511.1, C513.1, D506.2 (A), L502.2, R505.2, R513.1; also elsewhere on the board
+BATT_LOGIC: J501.1; also elsewhere on the board
/logic/PWM_EN_IN: J501.3; also elsewhere on the board
/logic/PWM_EN_RTN: J501.4; also elsewhere on the board
GNDD: C501.2, C503.2, C505.1, C511.2, D501.2 (A), D504.1 (K), R502.1, R506.1, U502.4 (RTN); also elsewhere on the board
unnamed: C502.2, C503.1
unnamed: C509.1, C513.2, R508.2
unnamed: C507.1, D501.1 (K), L502.1, R508.1, U502.1 (SW)
unnamed: D504.2 (A), R513.2
unnamed: C505.2, D506.1 (K), U502.7 (VCC)
unnamed: C501.1, C502.1, J501.2, R501.2, U502.8 (VIN)
unnamed: C507.2, U502.2 (BST)
unnamed: C509.2, R505.1, R506.2, U502.5 (FB)
unnamed: R502.2, U502.3 (RCL)
unnamed: R501.1, U502.6 (RON/SD)

Notes on the sheet:
Ripple injection (LM5008 needs >=25mV at FB): Rr=R508 / Cr=C513 across L502, Cac=C509 into FB ~45mV @ 36V in, ~50mV @ 60V in
J501 Enable / supply input
1 +BATT_LOGIC battery + 2 buck VIN (U502 LM5008) 3 PWM_EN_IN, optocoupler U1102 input + (12 - 40 V) 4 PWM_EN_RTN, optocoupler input return, battery - (floating, not GNDD) Bench: bridge 1-2, battery + to pin 3, battery - to pin 4. Cart: switch pin 2 (logic), pin 3 (phases).
1 BATT -> 12 V U502 LM5008 buck

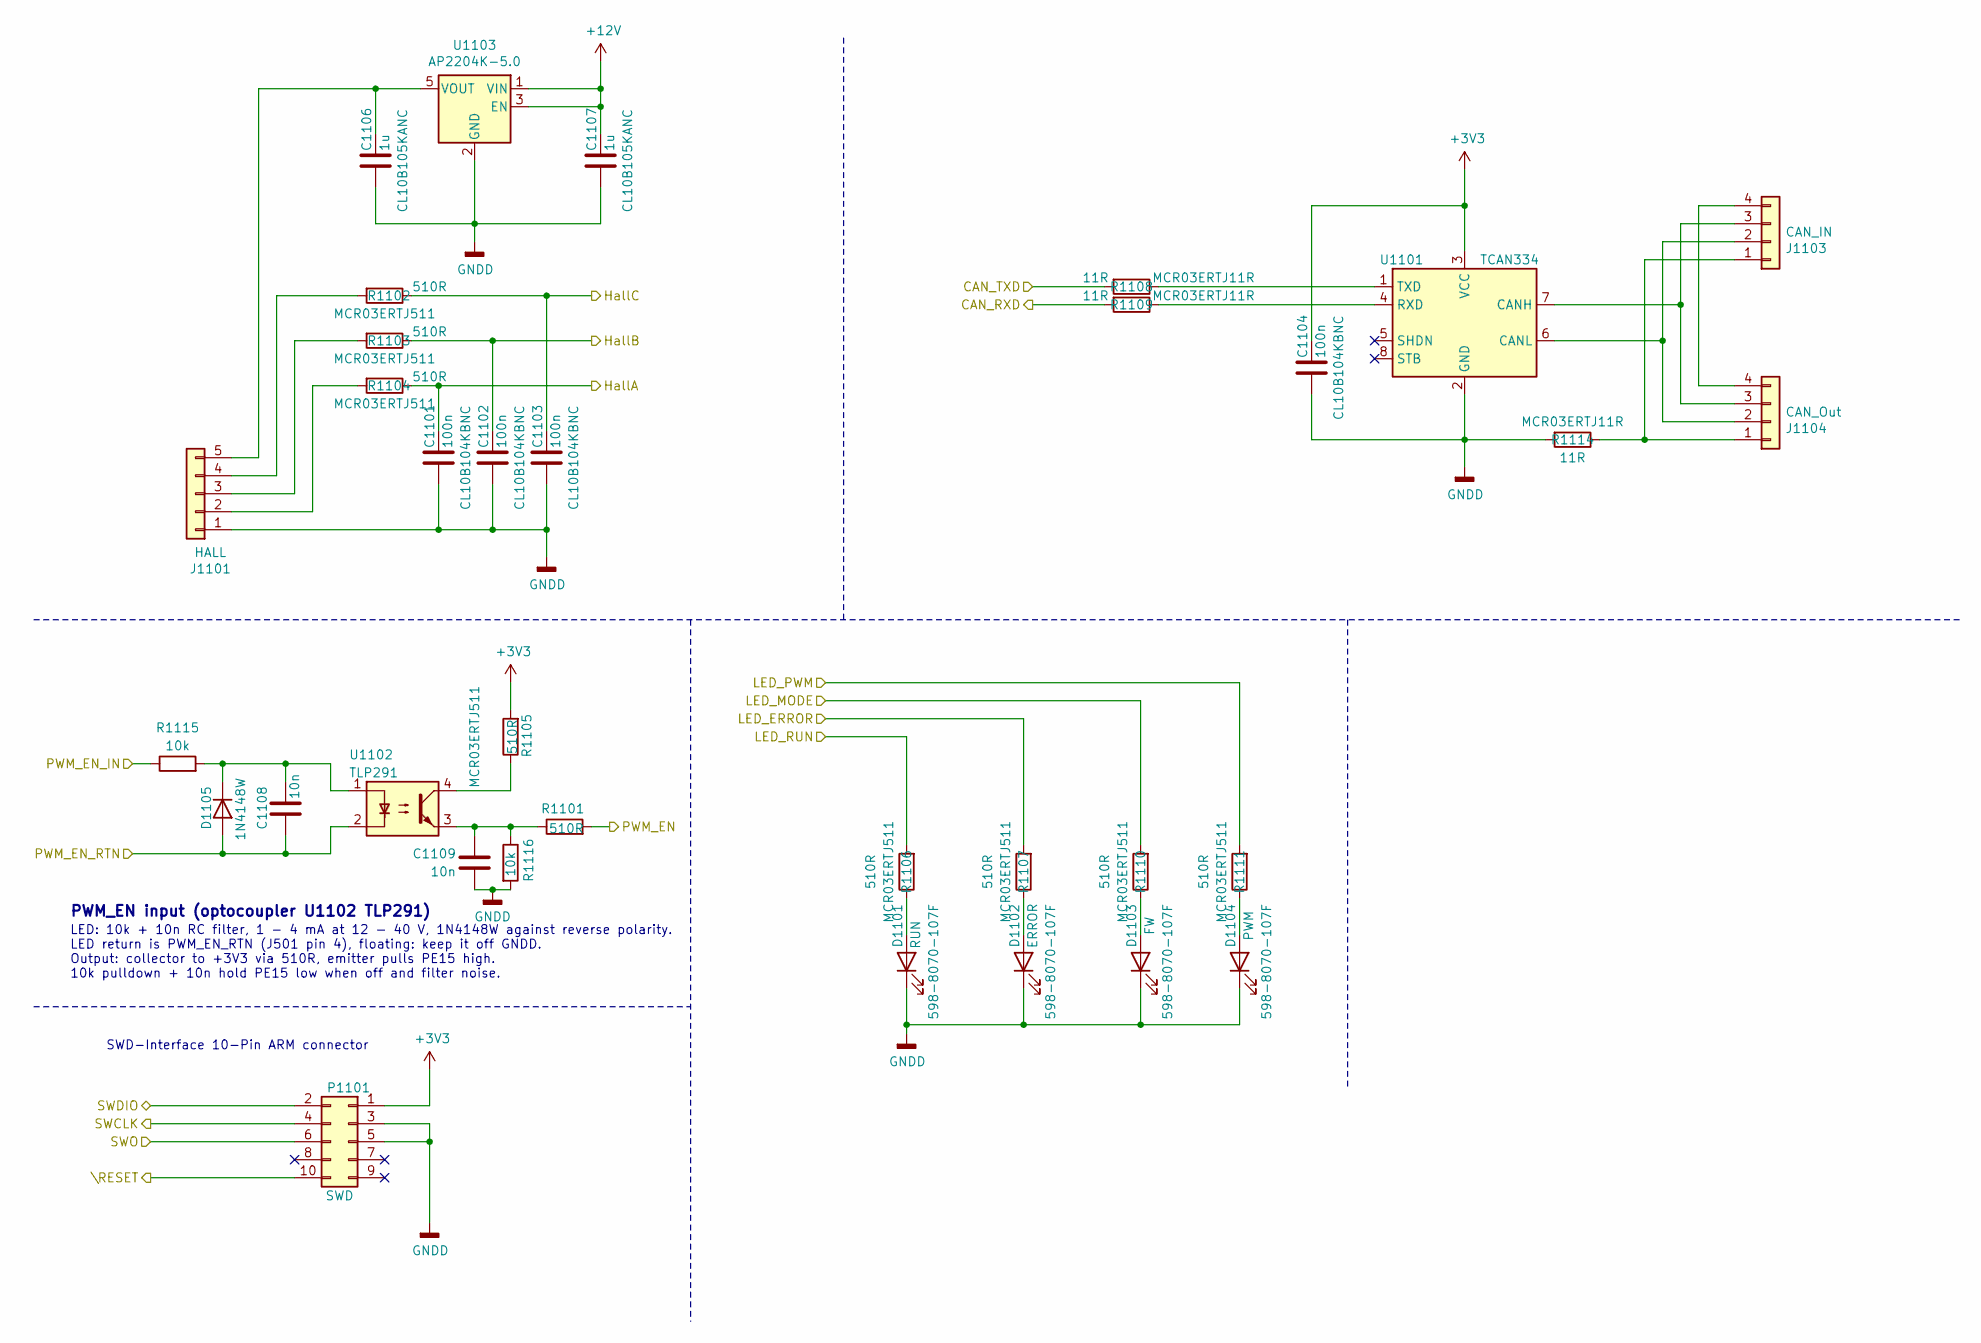
[picture p13: schematic interfaces.kicad_sch]

Parts:
C1101, C1102, C1103, C1104: 100n; C_0603_1608Metric; Part# CL10B104KBNC
C1106, C1107: 1u; C_0603_1608Metric; Part# CL10B105KANC
C1108, C1109: 10n; C_0603_1608Metric; Part# CL10B103KB8NNNC
D1101: RUN; LED_0603_1608Metric; Part# 598-8070-107F
D1102: ERROR; LED_0603_1608Metric; Part# 598-8070-107F
D1103: FW; LED_0603_1608Metric; Part# 598-8070-107F
D1104: PWM; LED_0603_1608Metric; Part# 598-8070-107F
D1105: 1N4148W; D_SOD-123; Part# 1N4148W
J1101: HALL; JST_PH_S5B-PH-K_1x05_P2.00mm_Horizontal; Part# C157923
J1103: CAN_IN; JST_PH_S4B-PH-K_1x04_P2.00mm_Horizontal; Part# C157926
J1104: CAN_Out; JST_PH_S4B-PH-K_1x04_P2.00mm_Horizontal; Part# C157926
P1101: SWD; PinHeader_2x05_P1.27mm_Vertical
R1101, R1102, R1103, R1104, R1105, R1106, R1107, R1110, R1111: 510R; R_0603_1608Metric; Part# MCR03ERTJ511
R1108, R1109, R1114: 11R; R_0603_1608Metric; Part# MCR03ERTJ11R
R1115: 10k; R_1206_3216Metric; Part# MCR18EZPJ103
R1116: 10k; R_0603_1608Metric; Part# MCR03ERTJ103
U1101: TCAN334; SOT-23-8; Part# TCAN334DCNR
U1102: TLP291; SOIC-4_4.55x2.6mm_P1.27mm; Part# TLP291
U1103: AP2204K-5.0; SOT-23-5

Connections:
+3V3: C1104.1, P1101.1, R1105.2, U1101.3 (VCC); also elsewhere on the board
+12V: C1107.1, U1103.1 (VIN), U1103.3 (EN); also elsewhere on the board
/logic/PWM_EN_IN: R1115.1; also elsewhere on the board
/logic/PWM_EN_RTN: C1108.2, D1105.2 (A), U1102.2; also elsewhere on the board
/logic/controller/interfaces/CAN_RXD: R1109.2; also elsewhere on the board
/logic/controller/interfaces/CAN_TXD: R1108.2; also elsewhere on the board
/logic/controller/interfaces/HallA: C1101.1, R1104.1; also elsewhere on the board
/logic/controller/interfaces/HallB: C1102.1, R1103.1; also elsewhere on the board
/logic/controller/interfaces/HallC: C1103.1, R1102.1; also elsewhere on the board
/logic/controller/interfaces/LED_ERROR: R1107.2; also elsewhere on the board
/logic/controller/interfaces/LED_MODE: R1110.2; also elsewhere on the board
/logic/controller/interfaces/LED_PWM: R1111.2; also elsewhere on the board
/logic/controller/interfaces/LED_RUN: R1106.2; also elsewhere on the board
/logic/controller/interfaces/PWM_EN: R1101.2; also elsewhere on the board
/logic/controller/interfaces/SWCLK: P1101.4; also elsewhere on the board
/logic/controller/interfaces/SWDIO: P1101.2; also elsewhere on the board
/logic/controller/interfaces/SWO: P1101.6; also elsewhere on the board
/logic/controller/mcu/\RESET: P1101.10; also elsewhere on the board
GNDD: C1101.2, C1102.2, C1103.2, C1104.2, C1106.2, C1107.2, C1109.2, D1101.1 (K), D1102.1 (K), D1103.1 (K), D1104.1 (K), J1101.1, P1101.3, P1101.5, R1114.2, R1116.2, U1101.2 (GND), U1103.2 (GND); also elsewhere on the board
unnamed: C1109.1, R1101.1, R1116.1, U1102.3
unnamed: D1101.2 (A), R1106.1
unnamed: D1102.2 (A), R1107.1
unnamed: D1103.2 (A), R1110.1
unnamed: D1104.2 (A), R1111.1
unnamed: C1108.1, D1105.1 (K), R1115.2, U1102.1
unnamed: J1101.2, R1104.2
unnamed: J1101.3, R1103.2
unnamed: J1101.4, R1102.2
unnamed: C1106.1, J1101.5, U1103.5 (VOUT)
unnamed: J1103.1, J1104.1, R1114.1
unnamed: J1103.2, J1104.2, U1101.6 (CANL)
unnamed: J1103.3, J1104.3, U1101.7 (CANH)
unnamed: J1103.4, J1104.4
unnamed: R1105.1, U1102.4
unnamed: R1109.1, U1101.4 (RXD)
unnamed: R1108.1, U1101.1 (TXD)

Notes on the sheet:
SWD-Interface 10-Pin ARM connector
LED: 10k + 10n RC filter, 1 - 4 mA at 12 - 40 V, 1N4148W against reverse polarity. LED return is PWM_EN_RTN (J501 pin 4), floating: keep it off GNDD. Output: collector to +3V3 via 510R, emitter pulls PE15 high. 10k pulldown + 10n hold PE15 low when off and filter noise.
PWM_EN input (optocoupler U1102 TLP291)

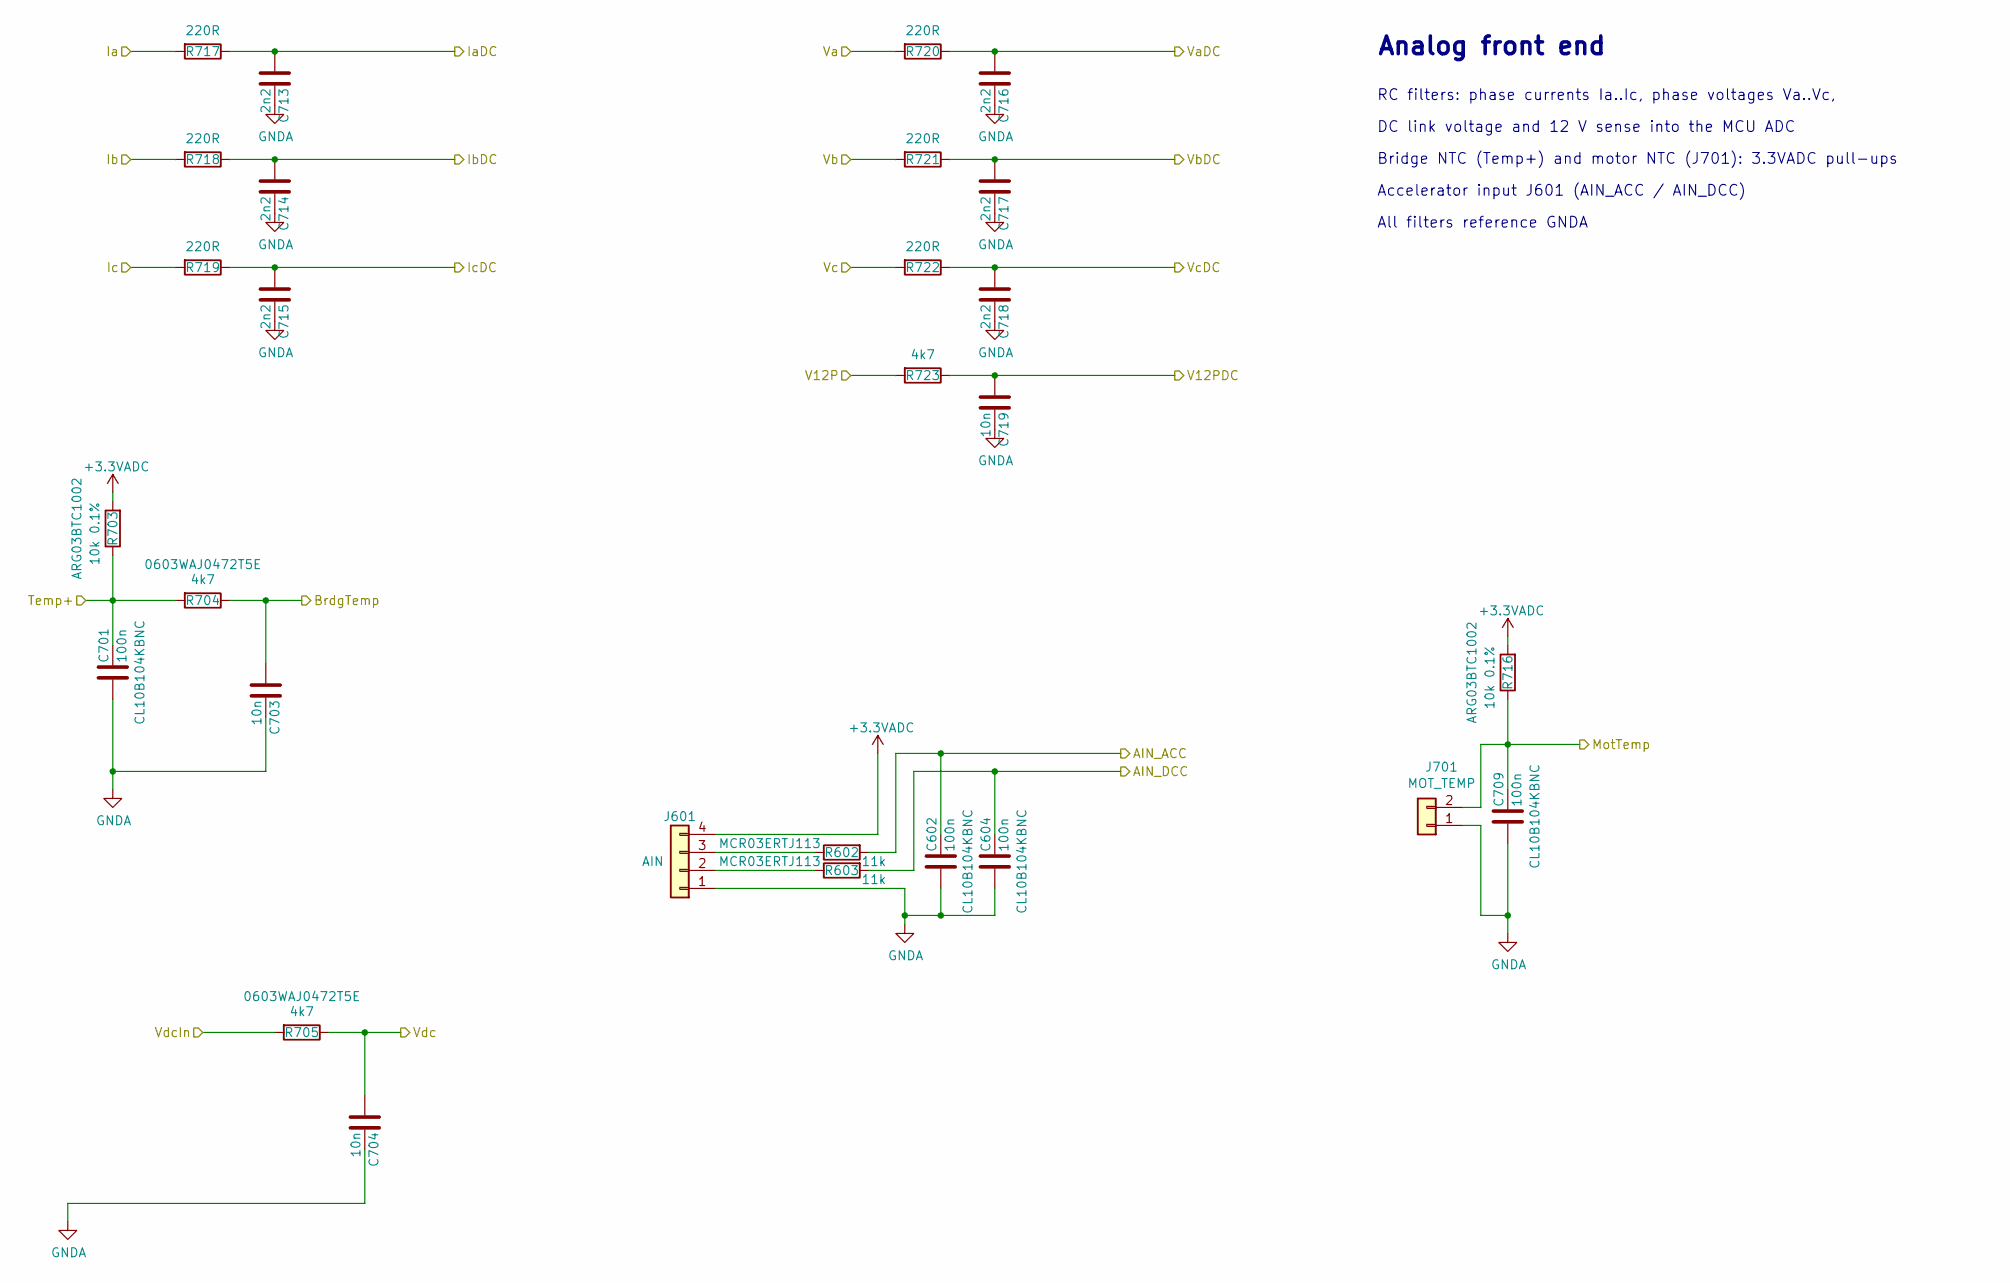
[picture p14: schematic analog.kicad_sch, Analog front end]

Parts:
C602, C604, C701, C709: 100n; C_0603_1608Metric; Part# CL10B104KBNC
C703, C704, C719: 10n; C_0603_1608Metric
C713, C714, C715, C716, C717, C718: 2n2; C_0603_1608Metric
J601: AIN; JST_PH_S4B-PH-K_1x04_P2.00mm_Horizontal; Part# C157926
J701: MOT_TEMP; JST_PH_S2B-PH-K_1x02_P2.00mm_Horizontal; Part# C157929
R602, R603: 11k; R_0603_1608Metric; Part# MCR03ERTJ113
R703, R716: 10k 0.1%; R_0603_1608Metric; Part# ARG03BTC1002
R704, R705: 4k7; R_0603_1608Metric; Part# 0603WAJ0472T5E
R717, R718, R719, R720, R721, R722: 220R; R_0603_1608Metric
R723: 4k7; R_0603_1608Metric

Connections:
+3.3VADC: J601.4, R703.2, R716.2; also elsewhere on the board
/logic/controller/Ia: R717.2; also elsewhere on the board
/logic/controller/Ib: R718.2; also elsewhere on the board
/logic/controller/Ic: R719.2; also elsewhere on the board
/logic/controller/Temp+: C701.1, R703.1, R704.2; also elsewhere on the board
/logic/controller/V12P: R723.2; also elsewhere on the board
/logic/controller/Va: R720.2; also elsewhere on the board
/logic/controller/Vb: R721.2; also elsewhere on the board
/logic/controller/Vc: R722.2; also elsewhere on the board
/logic/controller/VdcIn: R705.2; also elsewhere on the board
/logic/controller/analog/AIN_ACC: C602.1, R602.2; also elsewhere on the board
/logic/controller/analog/AIN_DCC: C604.1, R603.2; also elsewhere on the board
/logic/controller/analog/BrdgTemp: C703.2, R704.1; also elsewhere on the board
/logic/controller/analog/IaDC: C713.2, R717.1; also elsewhere on the board
/logic/controller/analog/IbDC: C714.2, R718.1; also elsewhere on the board
/logic/controller/analog/IcDC: C715.2, R719.1; also elsewhere on the board
/logic/controller/analog/MotTemp: C709.1, J701.2, R716.1; also elsewhere on the board
/logic/controller/analog/V12PDC: C719.2, R723.1; also elsewhere on the board
/logic/controller/analog/VaDC: C716.2, R720.1; also elsewhere on the board
/logic/controller/analog/VbDC: C717.2, R721.1; also elsewhere on the board
/logic/controller/analog/VcDC: C718.2, R722.1; also elsewhere on the board
/logic/controller/mcu/AIN_VDC: C704.2, R705.1; also elsewhere on the board
GNDA: C602.2, C604.2, C701.2, C703.1, C704.1, C709.2, C713.1, C714.1, C715.1, C716.1, C717.1, C718.1, C719.1, J601.1, J701.1; also elsewhere on the board
unnamed: J601.2, R603.1
unnamed: J601.3, R602.1

Notes on the sheet:
RC filters: phase currents Ia..Ic, phase voltages Va..Vc,
DC link voltage and 12 V sense into the MCU ADC
Accelerator input J601 (AIN_ACC / AIN_DCC)
All filters reference GNDA
Analog front end
Bridge NTC (Temp+) and motor NTC (J701): 3.3VADC pull-ups

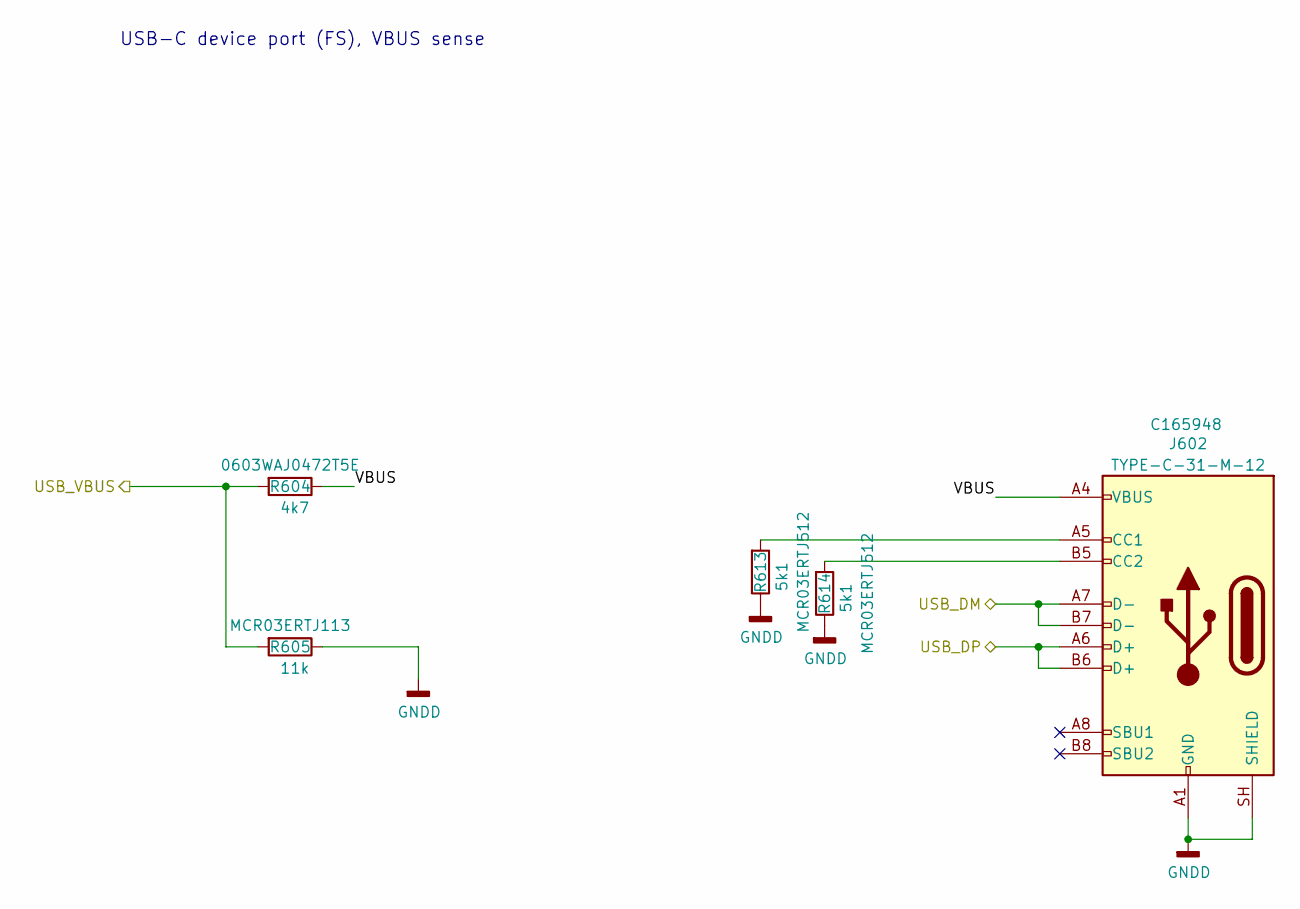
[picture p15: schematic usb.kicad_sch, USB-C device port]

Parts:
J602: TYPE-C-31-M-12; USB_C_Receptacle_HRO_TYPE-C-31-M-12; LCSC C165948
R604: 4k7; R_0603_1608Metric; Part# 0603WAJ0472T5E
R605: 11k; R_0603_1608Metric; Part# MCR03ERTJ113
R613, R614: 5k1; R_0603_1608Metric; Part# MCR03ERTJ512

Connections:
/logic/controller/mcu/USB_DM: J602.A7 (D-), J602.B7 (D-); also elsewhere on the board
/logic/controller/mcu/USB_DP: J602.A6 (D+), J602.B6 (D+); also elsewhere on the board
/logic/controller/mcu/USB_VBUS: R604.2, R605.2; also elsewhere on the board
/logic/controller/usb/VBUS: J602.A4 (VBUS), J602.A9 (VBUS), J602.B4 (VBUS), J602.B9 (VBUS), R604.1
GNDD: J602.A1 (GND), J602.A12 (GND), J602.B1 (GND), J602.B12 (GND), J602.SH (SHIELD), R605.1, R613.1, R614.1; also elsewhere on the board
unnamed: J602.A5 (CC1), R613.2
unnamed: J602.B5 (CC2), R614.2

Notes on the sheet:
USB-C device port (FS), VBUS sense

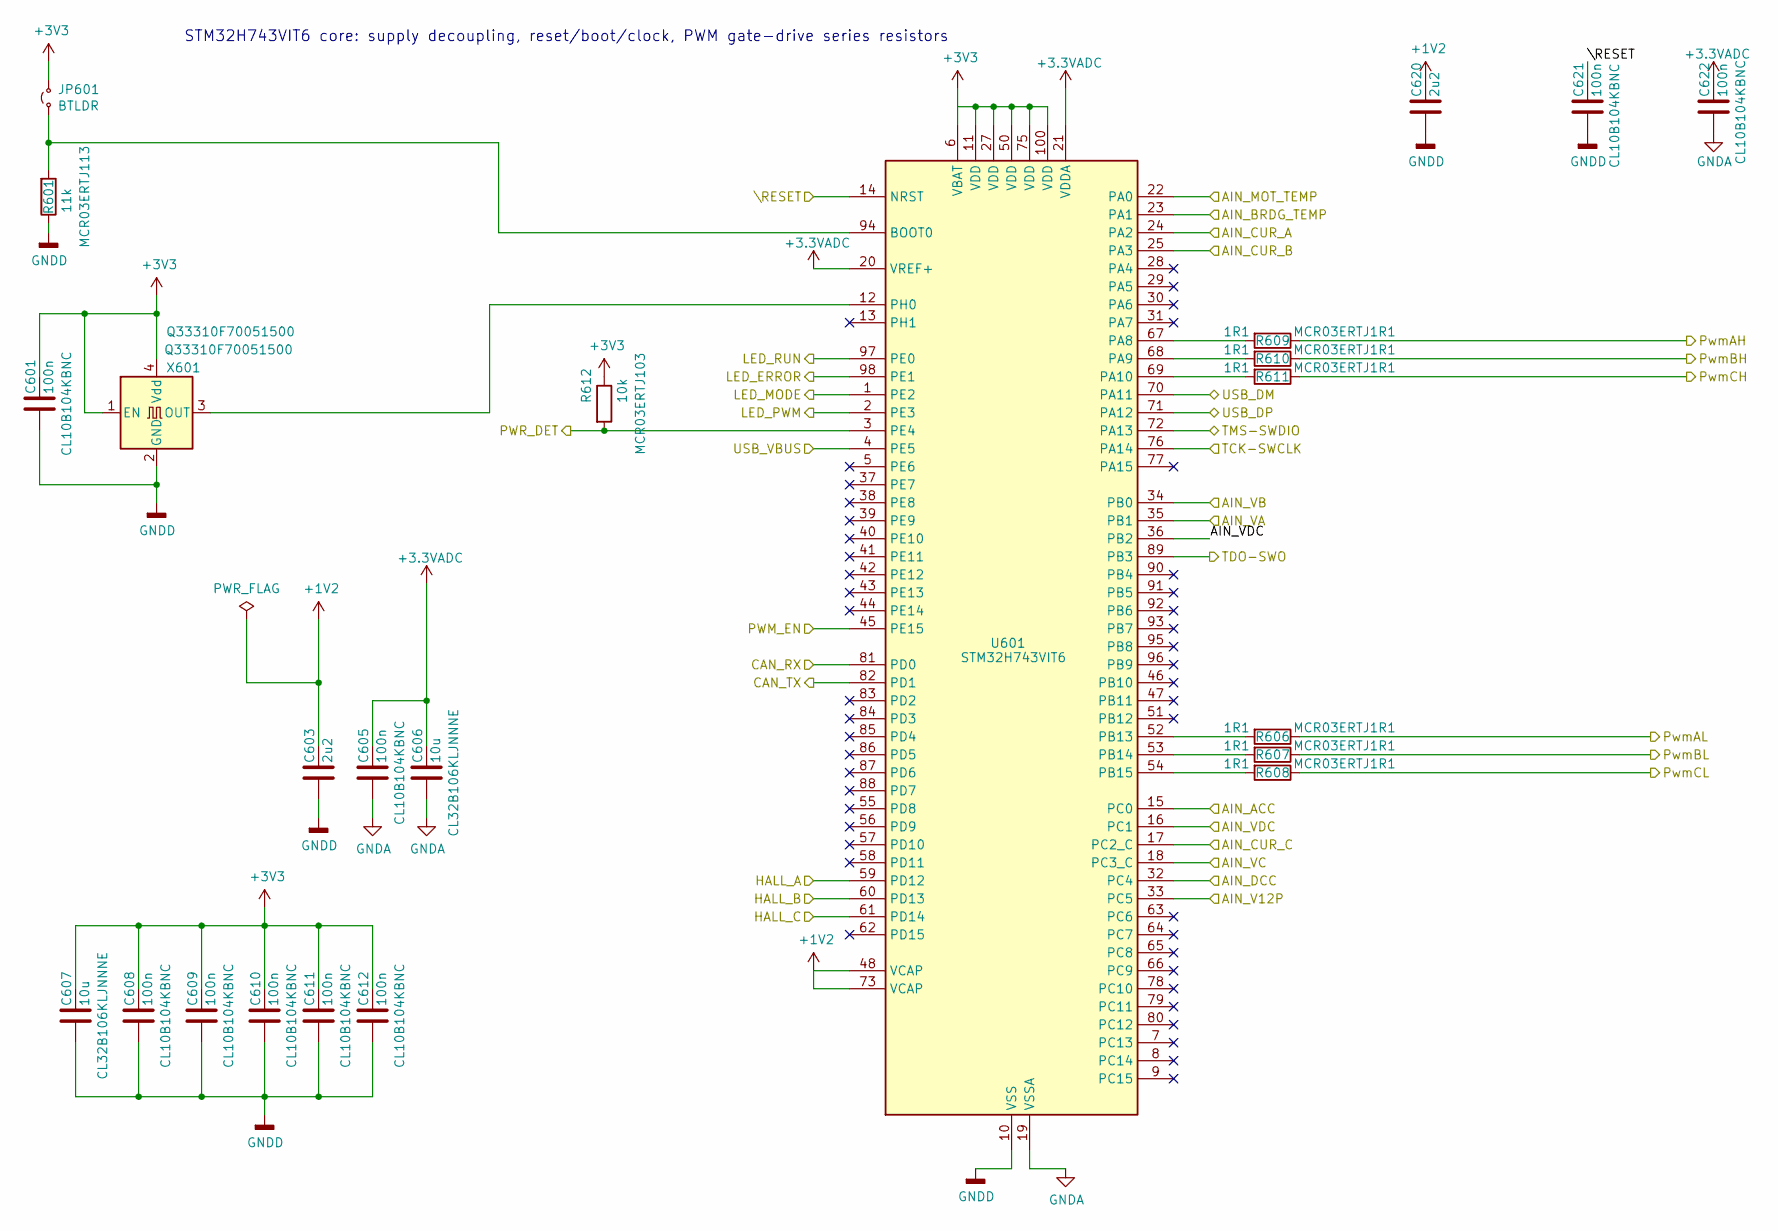
[picture p16: schematic mcu.kicad_sch, MCU: STM32H743VIT6]

Parts:
C601, C605, C608, C609, C610, C611, C612, C621, C622: 100n; C_0603_1608Metric; Part# CL10B104KBNC
C603, C620: 2u2; C_0603_1608Metric
C606, C607: 10u; C_1210_3225Metric; Part# CL32B106KLJNNNE
JP601: BTLDR; SolderJumper-2_P1.3mm_Open_RoundedPad1.0x1.5mm
R601: 11k; R_0603_1608Metric; Part# MCR03ERTJ113
R606, R607, R608, R609, R610, R611: 1R1; R_0603_1608Metric; Part# MCR03ERTJ1R1
R612: 10k; R_0603_1608Metric; Part# MCR03ERTJ103
U601: STM32H743VIT6; LQFP-100_14x14mm_P0.5mm; Part# 511-STM32H743VIT6; LCSC C114409
X601: Q33310F70051500; Oscillator_SMD_Abracon_ASE-4Pin_3.2x2.5mm; Part# Q33310F70051500; LCSC C32529

Connections:
+1V2: C603.1, C620.1, U601.48 (VCAP), U601.73 (VCAP)
+3.3VADC: C605.1, C606.1, C622.1, U601.20 (VREF+), U601.21 (VDDA); also elsewhere on the board
+3V3: C601.1, C607.1, C608.1, C609.1, C610.1, C611.1, C612.1, JP601.2 (B), R612.1, U601.6 (VBAT), U601.11 (VDD), U601.27 (VDD), U601.50 (VDD), U601.75 (VDD), U601.100 (VDD), X601.1 (EN), X601.4 (Vdd); also elsewhere on the board
/logic/controller/PWR_DET: R612.2, U601.3 (PE4); also elsewhere on the board
/logic/controller/PwmAH: R609.1; also elsewhere on the board
/logic/controller/PwmAL: R606.1; also elsewhere on the board
/logic/controller/PwmBH: R610.1; also elsewhere on the board
/logic/controller/PwmBL: R607.1; also elsewhere on the board
/logic/controller/PwmCH: R611.1; also elsewhere on the board
/logic/controller/PwmCL: R608.1; also elsewhere on the board
/logic/controller/analog/AIN_ACC: U601.15 (PC0); also elsewhere on the board
/logic/controller/analog/AIN_DCC: U601.32 (PC4); also elsewhere on the board
/logic/controller/analog/BrdgTemp: U601.23 (PA1); also elsewhere on the board
/logic/controller/analog/IaDC: U601.24 (PA2); also elsewhere on the board
/logic/controller/analog/IbDC: U601.25 (PA3); also elsewhere on the board
/logic/controller/analog/IcDC: U601.17 (PC2_C); also elsewhere on the board
/logic/controller/analog/MotTemp: U601.22 (PA0); also elsewhere on the board
/logic/controller/analog/V12PDC: U601.33 (PC5); also elsewhere on the board
/logic/controller/analog/VaDC: U601.35 (PB1); also elsewhere on the board
/logic/controller/analog/VbDC: U601.34 (PB0); also elsewhere on the board
/logic/controller/analog/VcDC: U601.18 (PC3_C); also elsewhere on the board
/logic/controller/interfaces/CAN_RXD: U601.81 (PD0); also elsewhere on the board
/logic/controller/interfaces/CAN_TXD: U601.82 (PD1); also elsewhere on the board
/logic/controller/interfaces/HallA: U601.59 (PD12); also elsewhere on the board
/logic/controller/interfaces/HallB: U601.60 (PD13); also elsewhere on the board
/logic/controller/interfaces/HallC: U601.61 (PD14); also elsewhere on the board
/logic/controller/interfaces/LED_ERROR: U601.98 (PE1); also elsewhere on the board
/logic/controller/interfaces/LED_MODE: U601.1 (PE2); also elsewhere on the board
/logic/controller/interfaces/LED_PWM: U601.2 (PE3); also elsewhere on the board
/logic/controller/interfaces/LED_RUN: U601.97 (PE0); also elsewhere on the board
/logic/controller/interfaces/PWM_EN: U601.45 (PE15); also elsewhere on the board
/logic/controller/interfaces/SWCLK: U601.76 (PA14); also elsewhere on the board
/logic/controller/interfaces/SWDIO: U601.72 (PA13); also elsewhere on the board
/logic/controller/interfaces/SWO: U601.89 (PB3); also elsewhere on the board
/logic/controller/mcu/AIN_VDC: U601.16 (PC1), U601.36 (PB2); also elsewhere on the board
/logic/controller/mcu/USB_DM: U601.70 (PA11); also elsewhere on the board
/logic/controller/mcu/USB_DP: U601.71 (PA12); also elsewhere on the board
/logic/controller/mcu/USB_VBUS: U601.4 (PE5); also elsewhere on the board
/logic/controller/mcu/\RESET: C621.1, U601.14 (NRST); also elsewhere on the board
GNDA: C605.2, C606.2, C622.2, U601.19 (VSSA); also elsewhere on the board
GNDD: C601.2, C603.2, C607.2, C608.2, C609.2, C610.2, C611.2, C612.2, C620.2, C621.2, R601.1, U601.10 (VSS), U601.26 (VSS), U601.49 (VSS), U601.74 (VSS), U601.99 (VSS), X601.2 (GND); also elsewhere on the board
unnamed: JP601.1 (A), R601.2, U601.94 (BOOT0)
unnamed: R609.2, U601.67 (PA8)
unnamed: R610.2, U601.68 (PA9)
unnamed: R611.2, U601.69 (PA10)
unnamed: R606.2, U601.52 (PB13)
unnamed: R607.2, U601.53 (PB14)
unnamed: R608.2, U601.54 (PB15)
unnamed: U601.12 (PH0), X601.3 (OUT)

Notes on the sheet:
STM32H743VIT6 core: supply decoupling, reset/boot/clock, PWM gate-drive series resistors

Board: 4 copper layers, 248 parts (15 on the bottom side), 157 nets, no tracks yet.
