Tecnologic/hardware_4850/hardware_4850.kicad_pcb

## KiCad design hardware_4850.kicad_pcb (2026-11-03)

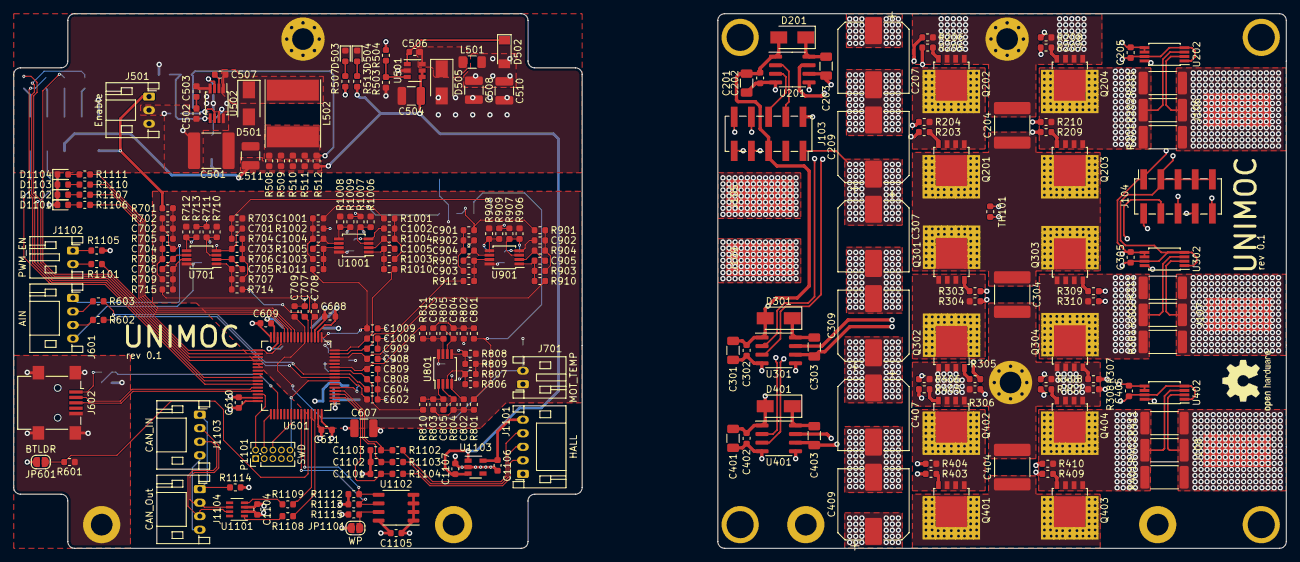
[picture p17: board hardware_4850.kicad_pcb from above]

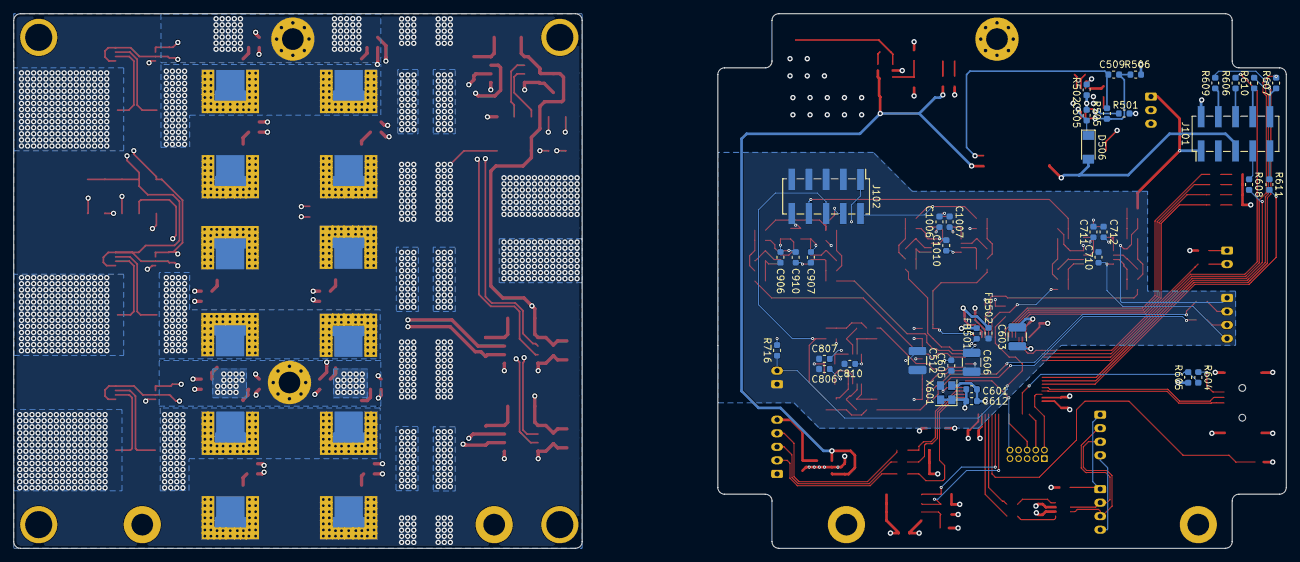
[picture p18: board hardware_4850.kicad_pcb from below]

Board: 4 copper layers, 188.1 x 79.0 mm, 290 parts (39 on the bottom side), 171 nets.

Parts:
C201, C203, C301, C303, C401, C403: 10u; C_1206_3216Metric
C202, C205, C302, C305, C402, C405, C502, C503, C506, C507, C601, C602, C604, C605, C608, C609, C610, C611, C612, C701, C707, C708, C709, C710, C711, C712, C806, C807, C808, C810, C906, C907, C908, C910, C1006, C1007, C1008, C1010, C1101, C1102, C1103, C1104, C1105: 100n; C_0603_1608Metric
C204, C304, C404, C501: 10u; C_2220_5650Metric
C207, C209, C307, C309, C407, C409: 56u; CP_Elec_10x10
C504, C508, C510, C511, C512: 22u; C_1210_3225Metric
C505, C1106, C1107: 1u; C_0603_1608Metric
C509: 2n2; C_0603_1608Metric
C603, C606, C607: 10u; C_1210_3225Metric
C702, C705, C706: 1n; C_0603_1608Metric
C703, C704: 10n; C_0603_1608Metric
C801, C802, C804, C901, C902, C904, C1001, C1002, C1004: 4n7; C_0603_1608Metric
C803, C805, C903, C905, C1003, C1005: 47p; C_0603_1608Metric
C809, C909, C1009: 100p; C_0603_1608Metric
D201, D301, D401, D501, D505: SS110R3G; D_SMA
D502, D506: PMLL4153; D_MiniMELF
D503: 3V3; LED_0603_1608Metric
D504: 12V; LED_0603_1608Metric
D1101: RUN; LED_0603_1608Metric
D1102: ERROR; LED_0603_1608Metric
D1103: FW; LED_0603_1608Metric
D1104: PWM; LED_0603_1608Metric
FB501, FB502: Ferrite_Bead_Small; R_0603_1608Metric
H101, H105, H106: GND; MountingHole_3.2mm_M3_Pad_Via
H102, H103, H104, H107: GND; MountingHole_3.2mm_M3_ISO14580_Pad
J101: PWM; PinHeader_2x05_P2.54mm_Vertical_SMD
J102: ADC; PinHeader_2x05_P2.54mm_Vertical_SMD
J103: PWM; PinSocket_2x05_P2.54mm_Vertical_SMD
J104: ADC; PinSocket_2x05_P2.54mm_Vertical_SMD
J105: +; SolderWirePad_1x01_SMD_5x10mm
J106: A; SolderWirePad_1x01_SMD_5x10mm
J107: B; SolderWirePad_1x01_SMD_5x10mm
J108: C; SolderWirePad_1x01_SMD_5x10mm
J109: GND; SolderWirePad_1x01_SMD_5x10mm
J501: Enable; JST_PH_S3B-PH-K_1x03_P2.00mm_Horizontal
J601: AIN; JST_PH_S4B-PH-K_1x04_P2.00mm_Horizontal
J602: USB_B_Mini; USB_Mini-B_Lumberg_2486_01_Horizontal
J701: MOT_TEMP; JST_PH_S2B-PH-K_1x02_P2.00mm_Horizontal
J1101: HALL; JST_PH_S5B-PH-K_1x05_P2.00mm_Horizontal
J1102: PWM_EN; JST_PH_S2B-PH-K_1x02_P2.00mm_Horizontal
J1103: CAN_IN; JST_PH_S4B-PH-K_1x04_P2.00mm_Horizontal
J1104: CAN_Out; JST_PH_S4B-PH-K_1x04_P2.00mm_Horizontal
JP601: BTLDR; SolderJumper-2_P1.3mm_Open_RoundedPad1.0x1.5mm
JP1101: WP; SolderJumper-2_P1.3mm_Open_RoundedPad1.0x1.5mm
L501: 4u7; L_1206_3216Metric
L502: 330u; L_Taiyo-Yuden_NR-80xx_HandSoldering
N101: Housing_Pad; RND-455-00370
P1101: SWD; PinHeader_2x05_P1.27mm_Vertical
Q201, Q202, Q203, Q204, Q301, Q302, Q303, Q304, Q401, Q402, Q403, Q404: NCEP6080AG; LFPAK56_ThermalVias-1
R201, R202, R211, R301, R302, R311, R401, R402, R411: 2mR; R_2512_6332Metric
R203, R204, R205, R206, R207, R208, R209, R210, R303, R304, R305, R306, R307, R308, R309, R310, R403, R404, R405, R406, R407, R408, R409, R410, R606, R607, R608, R609, R610, R611: 1R1; R_0603_1608Metric
R501: 220k; R_0603_1608Metric
R502: 100k; R_0603_1608Metric
R503, R505, R601, R602, R603, R605, R710, R711, R712, R713, R806, R807, R808, R809, R906, R907, R908, R909, R1006, R1007, R1008, R1009, R1115: 11k; R_0603_1608Metric
R504: 34k; R_0603_1608Metric
R506: 2k7; R_0603_1608Metric
R507, R1101, R1102, R1103, R1104, R1105, R1106, R1107, R1110, R1111: 510R; R_0603_1608Metric
R508, R509, R510, R511, R512, R1108, R1109, R1114: 11R; R_0603_1608Metric
R513: 3k3; R_0603_1608Metric
R604, R704, R705, R707, R709, R802, R902, R1002, R1112, R1113: 4k7; R_0603_1608Metric
R701: 24k 0.1%; R_0603_1608Metric
R702: 1k2 0.1%; R_0603_1608Metric
R703, R716: 10k 0.1%; R_0603_1608Metric
R706, R708: 47k; R_0603_1608Metric
R714, R715, R810, R811, R910, R911, R1010, R1011: 21R; R_0603_1608Metric
R801, R803, R901, R903, R1001, R1003: 9k1; R_0603_1608Metric
R804, R904, R1004: 470k; R_0603_1608Metric
R805, R905, R1005: 910k; R_0603_1608Metric
TH101: NTC 10k; R_0603_1608Metric
U201, U301, U401: LM5109BMA; SOIC-8_3.9x4.9mm_P1.27mm
U202, U302, U402: INA240A1PWR; TSSOP-8_4.4x3mm_P0.65mm
U501: LMR12010Y; SOT-23-6
U502: LM5008; MSOP-8_3x3mm_P0.65mm
U601: STM32F730R8Tx; LQFP-64_10x10mm_P0.5mm
U701, U801, U901, U1001: GS8632-MR; MSOP-8_3x3mm_P0.65mm
U1101: TCAN334; SOT-23-8
U1102: 24LC04; SO-8_3.9x4.9mm_P1.27mm
U1103: AP2204K-5.0; SOT-23-5
X601: SM44T; Oscillator_SMD_Abracon_ASE-4Pin_3.2x2.5mm

Connections:
+1V2: C603.1, U601.30
+3.3VA: C205.1, C305.1, C405.1, J104.1, U202.5, U202.6, U302.5, U302.6, U402.5, U402.6
+3.3VADC: C512.1, C605.1, C606.1, C710.1, C810.1, C910.1, C1010.1, FB501.1, J102.1, J601.4, R703.2, R710.2, R712.2, R716.2, R806.1, R808.1, R906.1, R908.1, R1006.1, R1008.1, U601.13, U701.8, U801.8, U901.8, U1001.8
+3V3: C508.1, C510.1, C601.1, C607.1, C608.1, C609.1, C610.1, C611.1, C612.1, C1104.1, C1105.1, D502.2, FB501.2, JP601.2, JP1101.1, L501.2, P1101.1, R504.2, R507.2, R1105.2, R1112.1, R1113.1, U601.1, U601.19, U601.32, U601.48, U601.64, U1101.3, U1102.8, X601.1, X601.4
+12P: C201.1, C202.1, C301.1, C302.1, C401.1, C402.1, D201.2, D301.2, D401.2, J103.5, U201.1, U301.1, U401.1
+12V: C504.1, C511.1, C1107.1, D506.2, J101.5, R508.1, R509.1, R510.1, R511.1, R512.1, R513.1, U501.4, U501.5, U1103.1, U1103.3
+48V: J101.1, J501.1, R701.2
+BATT: C204.1, C207.1, C209.1, C304.1, C307.1, C309.1, C404.1, C407.1, C409.1, J103.1, J105.1, Q201.5, Q203.5, Q301.5, Q303.5, Q401.5, Q403.5
/logic/controller/AIN_ACC: C602.1, R602.2, U601.8
/logic/controller/AIN_CUR_A: C808.2, R810.1, U601.10
/logic/controller/AIN_CUR_A_AC: C809.2, R811.1, U601.11
/logic/controller/AIN_DCC: C604.1, R603.2, U601.9
/logic/controller/BTLDR: JP601.1, R601.2, U601.60
/logic/controller/CAN_RX: R1109.2, U601.61
/logic/controller/CAN_TX: R1108.2, U601.62
/logic/controller/CLK: U601.5, X601.3
/logic/controller/EEPROM_SCL: R1113.2, U601.58, U1102.6
/logic/controller/EEPROM_SDA: R1112.2, U601.59, U1102.5
/logic/controller/Ia: C801.2, J102.6, R801.2
/logic/controller/Ib: C901.2, J102.4, R901.2
/logic/controller/Ic: C1001.2, J102.2, R1001.2
/logic/controller/PwmAH: J101.4, R609.1
/logic/controller/PwmAL: J101.6, R606.1
/logic/controller/PwmBH: J101.8, R610.1
/logic/controller/PwmBL: J101.10, R607.1
/logic/controller/PwmCH: J101.9, R611.1
/logic/controller/PwmCL: J101.7, R608.1
/logic/controller/TCK-SWCLK: P1101.4, U601.49
/logic/controller/TDO-SWO: P1101.6, U601.55
/logic/controller/TMS-SWDIO: P1101.2, U601.46
/logic/controller/Temp+: C701.1, J102.8, R703.1, R704.2
/logic/controller/USB_DM: J602.2, U601.44
/logic/controller/USB_DP: J602.3, U601.45
/logic/controller/USB_VBUS: R604.2, R605.2, U601.51
/logic/controller/\RESET: P1101.10, U601.7
/logic/controller/analog/BrdgTemp: C707.1, R714.2, U601.21
/logic/controller/analog/IbAC: C909.2, R911.1, U601.15
/logic/controller/analog/IbDC: C908.2, R910.1, U601.14
/logic/controller/analog/IcAC: C1009.2, R1011.1, U601.17
/logic/controller/analog/IcDC: C1008.2, R1010.1, U601.16
/logic/controller/analog/MotTemp: C709.1, J701.2, R716.1, U601.22
/logic/controller/analog/Vdc: C708.1, R715.2, U601.20
/logic/controller/interfaces/HallA: C1101.1, R1104.1, U601.2
/logic/controller/interfaces/HallB: C1102.1, R1103.1, U601.3
/logic/controller/interfaces/HallC: C1103.1, R1102.1, U601.4
/logic/controller/interfaces/LED_ERROR: R1107.2, U601.27
/logic/controller/interfaces/LED_MODE: R1110.2, U601.26
/logic/controller/interfaces/LED_PWM: R1111.2, U601.25
/logic/controller/interfaces/LED_RUN: R1106.2, U601.28
/logic/controller/interfaces/PWM_EN: R1101.2, U601.29, U601.33
/power/phase_a/I: J104.6, U202.8
/power/phase_a/Phase: J106.1, R201.1, R202.1, R211.1, U202.2
/power/phase_a/PwmH: J103.4, U201.2
/power/phase_a/PwmL: J103.6, U201.3
/power/phase_b/I: J104.4, U302.8
/power/phase_b/Phase: J107.1, R301.1, R302.1, R311.1, U302.2
/power/phase_b/PwmH: J103.8, U301.2
/power/phase_b/PwmL: J103.10, U301.3
/power/phase_c/I: J104.2, U402.8
/power/phase_c/Phase: J108.1, R401.1, R402.1, R411.1, U402.2
/power/phase_c/PwmH: J103.9, U401.2
/power/phase_c/PwmL: J103.7, U401.3
GND: C205.2, C305.2, C405.2, J104.3, J104.5, J104.7, J104.9, U202.1, U202.4, U202.7, U302.1, U302.4, U302.7, U402.1, U402.4, U402.7
GNDA: C512.2, C602.2, C604.2, C605.2, C606.2, C701.2, C702.1, C703.1, C704.1, C707.2, C708.2, C709.2, C710.2, C711.2, C712.2, C802.1, C806.1, C807.1, C808.1, C809.1, C810.2, C902.1, C906.1, C907.1, C908.1, C909.1, C910.2, C1002.1, C1006.1, C1007.1, C1008.1, C1009.1, C1010.2, FB502.1, J102.3, J102.5, J102.7, J102.9, J102.10, J601.1, J701.1, R702.2, R711.1, R713.1, R802.2, R807.2, R809.2, R902.2, R907.2, R909.2, R1002.2, R1007.2, R1009.2, U601.12, U701.4, U801.4, U901.4, U1001.4
GNDD: C501.2, C503.2, C504.2, C505.1, C508.2, C510.2, C511.2, C601.2, C603.2, C607.2, C608.2, C609.2, C610.2, C611.2, C612.2, C1101.2, C1102.2, C1103.2, C1104.2, C1105.2, C1106.2, C1107.2, D501.2, D503.1, D504.1, D505.2, D1101.1, D1102.1, D1103.1, D1104.1, FB502.2, H101.1, H102.1, H103.1, J101.2, J501.3, J602.5, J602.6, J1101.1, P1101.3, P1101.5, R502.1, R503.1, R506.1, R601.1, R605.1, R1114.2, R1115.2, U501.2, U502.4, U601.18, U601.31, U601.47, U601.63, U1101.2, U1102.1, U1102.2, U1102.3, U1102.4, U1103.2, X601.2
GNDPWR: C204.2, C207.2, C209.2, C304.2, C307.2, C309.2, C404.2, C407.2, C409.2, H104.1, H105.1, H106.1, H107.1, J103.2, J109.1, N101.1, Q202.1, Q202.2, Q202.3, Q204.1, Q204.2, Q204.3, Q302.1, Q302.2, Q302.3, Q304.1, Q304.2, Q304.3, Q402.1, Q402.2, Q402.3, Q404.1, Q404.2, Q404.3, R206.1, R208.1, R306.1, R308.1, R406.1, R408.1
unnamed: C502.2, C503.1
unnamed: C509.1, L502.2, R505.2, R508.2, R509.2, R510.2, R511.2, R512.2
unnamed: C702.2, R701.1, R702.1, R705.2
unnamed: C703.2, R704.1, R706.2, R707.2
unnamed: C704.2, R705.1, R708.2, R709.2
unnamed: C801.1, C803.2, C804.2, R802.1
unnamed: C802.2, R801.1, R803.2, R804.2
unnamed: C901.1, C903.2, C904.2, R902.1
unnamed: C902.2, R901.1, R903.2, R904.2
unnamed: C1001.1, C1003.2, C1004.2, R1002.1
unnamed: C1002.2, R1001.1, R1003.2, R1004.2
unnamed: C203.1, D201.1, U201.8
unnamed: C303.1, D301.1, U301.8
unnamed: C403.1, D401.1, U401.8
unnamed: C507.1, D501.1, L502.1, U502.1
unnamed: C506.2, D502.1, U501.1
unnamed: D503.2, R507.1
unnamed: D504.2, R513.2
unnamed: C506.1, D505.1, L501.1, U501.6
unnamed: C505.2, D506.1, U502.7
unnamed: D1101.2, R1106.1
unnamed: D1102.2, R1107.1
unnamed: D1103.2, R1110.1
unnamed: D1104.2, R1111.1
unnamed: J104.8, TH101.1
unnamed: J104.10, TH101.2
unnamed: C501.1, C502.1, J501.2, R501.2, U502.8
unnamed: J601.2, R603.1
unnamed: J601.3, R602.1
unnamed: J602.1, R604.1
unnamed: J1101.2, R1104.2
unnamed: J1101.3, R1103.2
unnamed: J1101.4, R1102.2
unnamed: C1106.1, J1101.5, U1103.5
unnamed: J1102.1, R1105.1
unnamed: J1102.2, R1101.1
unnamed: J1103.1, J1104.1, R1114.1
unnamed: J1103.2, J1104.2, U1101.6
unnamed: J1103.3, J1104.3, U1101.7
unnamed: J1103.4, J1104.4
unnamed: JP1101.2, R1115.1, U1102.7
unnamed: Q201.4, R203.1
unnamed: Q201.1, Q201.2, Q201.3, Q202.5, Q203.1, Q203.2, Q203.3, Q204.5, R201.2, R202.2, R204.1, R210.1, R211.2, U202.3
unnamed: Q202.4, R205.1
unnamed: Q203.4, R209.1
unnamed: Q204.4, R207.1
unnamed: Q301.4, R303.1
unnamed: Q301.1, Q301.2, Q301.3, Q302.5, Q303.1, Q303.2, Q303.3, Q304.5, R301.2, R302.2, R304.1, R310.1, R311.2, U302.3
unnamed: Q302.4, R305.1
unnamed: Q303.4, R309.1
unnamed: Q304.4, R307.1
unnamed: Q401.4, R403.1
unnamed: Q401.1, Q401.2, Q401.3, Q402.5, Q403.1, Q403.2, Q403.3, Q404.5, R401.2, R402.2, R404.1, R410.1, R411.2, U402.3
unnamed: Q402.4, R405.1
unnamed: Q403.4, R409.1
unnamed: Q404.4, R407.1
unnamed: R203.2, R209.2, U201.7
unnamed: C203.2, R204.2, R210.2, U201.6
unnamed: R205.2, R207.2, U201.5
unnamed: C201.2, C202.2, R206.2, R208.2, U201.4
unnamed: R303.2, R309.2, U301.7
unnamed: C303.2, R304.2, R310.2, U301.6
unnamed: R305.2, R307.2, U301.5
unnamed: C301.2, C302.2, R306.2, R308.2, U301.4
unnamed: R403.2, R409.2, U401.7
unnamed: C403.2, R404.2, R410.2, U401.6
unnamed: R405.2, R407.2, U401.5
unnamed: C401.2, C402.2, R406.2, R408.2, U401.4
unnamed: R503.2, R504.1, U501.3
unnamed: C507.2, U502.2
unnamed: C509.2, R505.1, R506.2, U502.5
unnamed: R502.2, U502.3
unnamed: R501.1, U502.6
unnamed: R609.2, U601.41
unnamed: R610.2, U601.42
unnamed: R611.2, U601.43
unnamed: R606.2, U601.34
unnamed: R607.2, U601.35
unnamed: R608.2, U601.36
unnamed: C711.1, R710.1, R711.2, U701.3
unnamed: C705.2, R706.1, U701.2
unnamed: C705.1, R707.1, R714.1, U701.1
unnamed: C712.1, R712.1, R713.2, U701.5
unnamed: C706.2, R708.1, U701.6
unnamed: C706.1, R709.1, R715.1, U701.7
unnamed: C806.2, R806.2, R807.1, U801.3
unnamed: C805.1, R804.1, U801.2
unnamed: C805.2, R803.1, R810.2, U801.1
unnamed: C807.2, R808.2, R809.1, U801.5
unnamed: C804.1, R805.2, U801.6
unnamed: C803.1, R805.1, R811.2, U801.7
unnamed: C906.2, R906.2, R907.1, U901.3
unnamed: C905.1, R904.1, U901.2
unnamed: C905.2, R903.1, R910.2, U901.1
unnamed: C907.2, R908.2, R909.1, U901.5
unnamed: C904.1, R905.2, U901.6
unnamed: C903.1, R905.1, R911.2, U901.7
unnamed: C1006.2, R1006.2, R1007.1, U1001.3
unnamed: C1005.1, R1004.1, U1001.2
unnamed: C1005.2, R1003.1, R1010.2, U1001.1
unnamed: C1007.2, R1008.2, R1009.1, U1001.5
unnamed: C1004.1, R1005.2, U1001.6
unnamed: C1003.1, R1005.1, R1011.2, U1001.7
unnamed: R1109.1, U1101.4
unnamed: R1108.1, U1101.1
