Tecnologic/hardware_4850/(commit log)

2026-10-31 Merge logic and power board into one KiCad 10 project
    - Convert both KiCad 5.1 projects to KiCad 10 (schematics with the original
    KiCad 5 symbols, boards via kicad-cli upgrade)
    - One root schematic with the sheets "logic" and "power"
    - One PCB with both boards side by side (power board right of the logic
    board), footprints linked to the merged schematic, nets renamed to the
    hierarchical names, zones refilled
    - Net classes (Dig Supply, GateDrive) and design rules restored in the
    project file
    - Shared files (footprints, datasheets, license) merged, KiCad 5 production
    data moved to production/legacy_kicad5
    - README with project structure and known schematic/PCB differences
    Co-Authore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
2026-10-31 Add aux bridge to the power board, G474 logic board concept
    - Schematic values follow the PCB (NCEP6080AG, 56u, 1R1); the outdated
    Part# order numbers of these parts are cleared
    - New sheet aux_leg (derived from the phase sheet, INA240 removed, low-side
    shunt with Kelvin pair and net tie), used twice as aux_a/aux_b: an
    asymmetric H-bridge for an EESM field winding or a PMSM brake chopper
    - Power sheet on A3 with the aux sheets, terminals F1/F2/DC+ (J111-J113)
    and the AUX connector J110 to the logic board
    - Remove stray "?" instances from the KiCad 5 import and a duplicate
    #PWR0107 (fixes the annotation warning)
    - docs/g474_logic_board.md: STM32G474RET6 concept with pin assignment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
2026-10-31 Logic board concept on the STM32G473RET6 instead of the G474
    The G473 differs from the G474 only by the missing HRTIM (checked with ST's
    pin data) and is the part at hand (and the BCC's MCU). The aux bridge moves
    to TIM8 (leg A CH3/CH3N on PC8/PB1, leg B CH1/CH1N on PC6/PB3), the chopper
    uses COMP3 on the TIM8 OCREF clear, the E-stop goes to TIM1_BKIN and
    TIM8_BKIN. SWO is dropped (log on RTT), USB VBUS sense moves to PF1.
    Claude-Session: https://claude.ai/code/session_01Jx3baKY9gE77ezuoANru2g
2026-11-01 Logic board concept on the STM32H743VIT6
    The 48-pin G473 (38 I/O) is too small for the 4850 logic board, and the
    BCC and the 4850 are redesigned around the STM32H743VIT6 (M7, 480 MHz,
    2 MB dual-bank flash, FDCAN, LQFP100). New pin assignment from ST's pin
    data: phases on TIM1, aux bridge on TIM8, OPAMP1 as PGA for the aux
    shunt, COMP1 for the overvoltage and the chopper, COMP2 for the aux
    overcurrent, an external quad comparator for the phase overcurrent.
    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
2026-11-03 Clean up repo layout, move mechanical files, update schematics and PCB
    - Move enclosure and heatsink DXF/STEP files into mechanical/
    - Move legacy BOM to production/legacy_kicad5/logic/
    - Remove obsolete aux_leg/current_filters sheets, sim files, F730 pinning and datasheet
    - Add C_2220 and LFPAK56 thermal-via footprints, drop KWSL shunt footprint
    - Update schematics, PCB, README and H743 logic board docs
2026-11-03 Rename project to Jacobi, the unimoc 48 V / 50 A drive
    - Rename hardware_4850.kicad_{pro,sch,pcb} to jacobi.kicad_*
    - Rename footprint library hardware_4850.pretty to jacobi.pretty and relink footprints
    - Update project name in sheet instances and title blocks
    - README: describe Jacobi as the unimoc drive hardware and add the node naming tables
2026-11-03 updated schematic plan
2026-11-04 Document ratings and limits: 36 V / 45 A, 100 A peak phase current
    Add a "Ratings and limits" section to the README with the decisions and
    estimates behind the rating: 60 V NCEP6080AG bridge (LCSC C182469) limits
    the battery to 36 V lead-acid or 10S Li-ion, target motors saturate at
    about 100 A peak, bridge losses, thermal path and cooling improvements,
    and the 0.5 mOhm + INA240A1 current sensing (±160 A, trip 120-130 A).
2026-11-04 Replace LM5008 series ripple resistors with RC ripple injection
    Remove R509-R512 (5x 11R in series with output) and connect L502
    directly to +12V. R508 (100k) and new C513 (4n7) form the ripple
    network across L502; C509 (now 4n7) couples it into FB.
    Gives ~40-50mV FB ripple over 36-60V input without DC drop.
2026-11-04 Split logic power supply into one A4 sheet per stage
    power_supply.kicad_sch becomes an A4 overview with three sub-sheets:
    - psu_12v (power_supply_12v.kicad_sch): 48 V -> 12 V, LM5008 buck
    - psu_3v3 (power_supply_3v3.kicad_sch): 12 V -> 3V3 digital, LMR12010
    - psu_3v3a (power_supply_3v3a.kicad_sch): 12 V -> 3V3 analog, LP2985 LDO,
    plus the GNDD/GNDA single-point tie
    Each stage is spread out to use the A4 page. Netlist is unchanged (same
    nets, references and footprints); stages connect only via global power
    symbols. Pages renumbered: power_supply 6, stages 7-9.
2026-11-04 Update schematics and add datasheets
    Pending schematic work across analog, controller, logic, power and phase
    sheets, plus project settings. Add datasheets for STM32H743VI, LP2985 and
    NCEP6080AG; remove the PAS torque sensor image.
2026-11-04 Split controller into A4 sheets: mcu, usb, analog, interfaces
    controller.kicad_sch (A3) becomes an A4 overview with four sub-sheets:
    - mcu (new): STM32H743 with decoupling, reset/boot/clock, PWM series
    resistors, PWR_DET pull-up
    - usb (new): USB-C port, CC resistors, VBUS divider
    - analog: gains the accelerator/DC-command input connector J601
    - interfaces: unchanged
    Netlist is unchanged (210 nets, identical pin sets). Pages renumbered
    1-15 and the project sheet list updated.
2026-11-04 Wire MCU PWM resistors, PWR_DET, clock and boot directly to MCU pins
    Replace net labels with direct wires on the mcu sheet.
2026-11-05 Split power board into A4 sheets, add notes and AGENTS.md
    power.kicad_sch (A3) becomes an A4 overview with sheets connectors,
    interface, sense and phase_a/b/c. Signals cross sheets through
    hierarchical labels. logic, analog and jacobi get title blocks and notes.
    AGENTS.md records the schematic sheet rules.
    Netlist unchanged (210 nets, identical pin sets). Pages renumbered 1-18.
2026-11-05 Tidy phase sheet layout
    Redraw wiring left to right: driver, half bridge, shunt and INA240.
    Second leg gate and source resistors use net labels instead of wires
    across the first leg. Local power symbols replace the INA240 supply
    loop. Add heading and notes.
    Netlist unchanged (210 nets, identical pin sets).
2026-11-05 Make low-side source links 0R with net ties, add PSU sheets
    R206/R208 become 0R with net ties NT2xx/3xx/4xx at the low FET sources to
    force Kelvin routing of driver VSS. Includes the KiCad re-save of all
    sheets and the new psu_12v/psu_3v3/psu_3v3a sheets in the project.
2026-11-05 Change X601 to Epson Q33310F70051500 (LCSC C32529)
    Replaces the SM44T 20 MHz oscillator; same 3.2x2.5 mm 4-pin pinout, so the
    footprint and nets are unchanged. Adds the datasheet and LCSC number.
2026-11-05 Update mcu and phase sheets, add PCB update report
    Schematic edits to mcu and phase sheets; report.txt is the log from Update PCB from Schematic, kept to review net changes.
2026-11-05 Label shunt sense net Phase on phase sheet
    Joins the INA240 + input to the phase output net, so the PCB Phase vias keep their net on update. Also includes the board after Update PCB and stale track cleanup.
2026-11-05 Remove stale tracks and vias after PCB update
    Deleted tracks and vias left on old nets (mainly around U601) that DRC flagged as shorting or dangling; phase nets untouched. Zones refilled.
2026-11-05 Clear tracks, place logic sections and VSENSE pair, drop net ties
    Removed all tracks and vias to restart routing. Placed the MCU, analog and
    3V3A parts on the logic board in sections, and put J110/J111 VSENSE on the
    power board output side with matching positions on both boards. Removed the
    net ties NT2xx-NT4xx; the 0R gate-return resistors now connect to GNDPWR.
2026-11-05 Use M3 solder terminals, equalize phase cells, move USB to board edge
    Power connections J105-J109 now use XFCN TT34086077-0910 (LCSC C19724597)
    with a new footprint. The three phase cells share one layout (translated by
    the cap pitch), ADC/VSENSE connectors sit in the right column with their
    logic-board mates, and the USB-C shell is flush with the board edge.
2026-11-06 Add 47k gate pulldown resistors to phase FETs
    Hold each FET gate off to its source when the LM5109 is unpowered. R211-R214 (R3xx/R4xx on the other phases).
2026-11-06 Place gate pulldown resistors, clear copper zones on PCB
    Add R211-214/R311-314/R411-414 next to the phase FET gates and remove all pour zones so routing can restart. Includes the updated phase and connector sheets.
2026-11-06 Fix solder mask and courtyard DRC errors
    Set mask min web to 0.1 mm and pad-to-mask to 0.04 mm for the fine-pitch ICs. Move J109 up and shift the phase C driver section 3.1 mm so J109 clears the N101 pad and H104.
2026-11-06 Place left-column FET resistors like the phase C cluster, note mounting hole rule
    Arrange gate, source and pulldown resistors of Q x01/x02 as hand-placed for Q401. Add PCB rules section to AGENTS.md: do not move H101-H107 except H106.
2026-11-06 Replace PWM_EN jumper J1102 with TLP291 optocoupler input on J501
    J501 is now 4-pin: +48V, buck VIN, PWM_EN_IN (opto LED +), PWM_EN_RTN
    (opto LED return, floating, not GNDD) so the enable input is isolated
    from logic ground and quiet on a cart with four drives.
2026-11-06 Rename logic board +48V to +BATT_LOGIC, document 12-40 V enable input
    The FETs limit the board to 36-44 V, so the 48 V naming was wrong. The
    net stays separate from +BATT on the power board. README and the H743
    notes now describe the optocoupler enable input on J501.
2026-11-06 Replace phase R204/206/208/210 resistors with net ties
    Saves space on the power board. The 0R links and the 1R1 HS resistors become copper ties.
2026-11-06 Unlock old footprints, lock only mounting holes and board connectors
    Old footprints could not be moved. Locked now: H101-H105, H107, J101-J104, J110, J111, N101. The file also holds the PCB update for the optocoupler input.
2026-11-06 Update footprints to current KiCad library, apply JLCPCB 4-layer design rules
    Resistors, caps, L501 and ICs now match the library pads (U1101 kept: library
    SOT-23-8 pad gap violates 0.2 mm clearance). Rules follow JLCPCB standard
    4-layer capabilities; DRC shows no new errors.
2026-11-06 Rebuild net classes for JLCPCB 4-layer rules, document PCB process in README
    Old patterns pointed at renamed nets and +BATT/phase nets had no power class.
    Classes: Power, GateDrive, Dig Supply, Analog Supply, Analog, USB. Board is
    1 oz copper, so drop the 2 oz remark. DRC unchanged.
